wagiminator/CH32V003-GameConsole/README.md

# CH32V003 RISC-V Mini Game Console
Mini Game Console utilizing the CH32V003J4M6 ultra-cheap (10 cents by the time of writing) 32-bit RISC-V microcontroller, an SSD1306 128x64 pixels OLED display and CR/LIR2032 coin cell battery holder.

- Project Video (YouTube): https://youtu.be/1W7Z0BodhWk
- PCB Design Files (EasyEDA): https://oshwlab.com/wagiminator/ch32v003j4m6-game-console

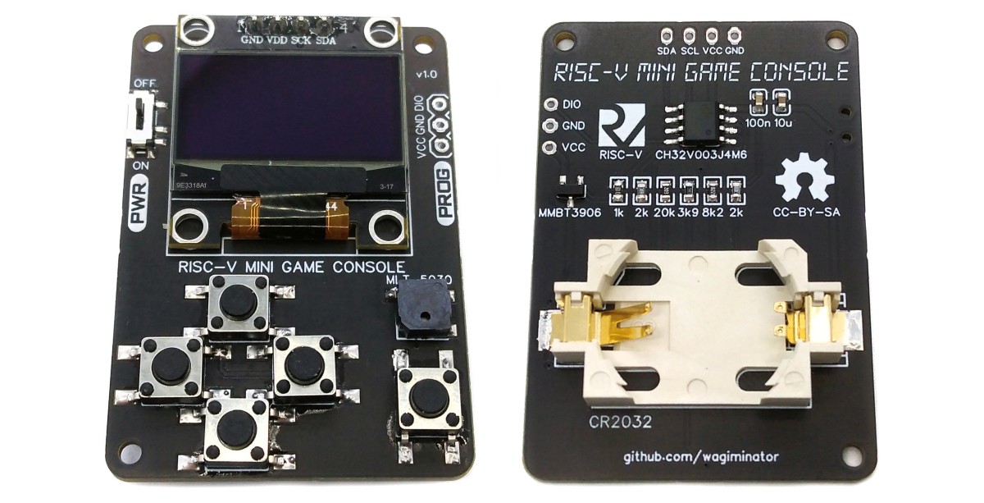
[picture p1: documentation/GameConsole_pic1.jpg]


# Hardware
## Schematic
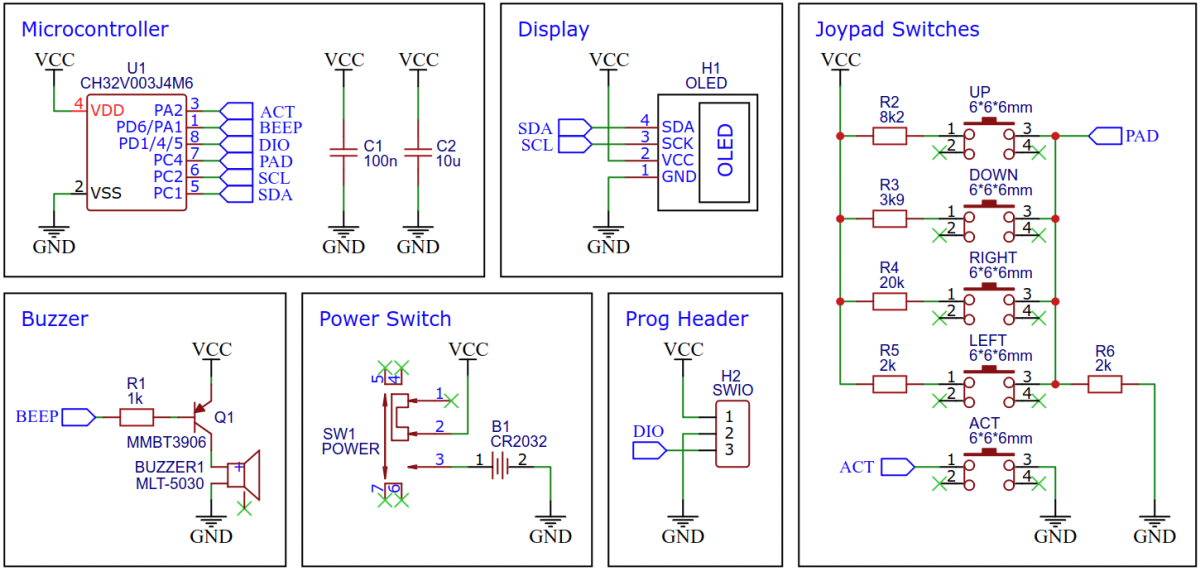
[picture p2: documentation/GameConsole_wiring.png]


## The CH32V003 Family of 32-bit RISC-V Microcontrollers
The CH32V003 series is a collection of industrial-grade general-purpose microcontrollers that utilize the QingKe RISC-V2A core design supporting the RV32EC instruction set. These microcontrollers are equipped with various features such as a 48MHz system main frequency, 16KB flash, 2KB SRAM, 2.7V - 5.5V supply voltage support, a single-wire serial debug interface, low power consumption, and an ultra-small package. Additionally, the CH32V003 series includes a built-in set of components including a DMA controller, a 10-bit ADC, op-amp comparators, multiple timers, and standard communication interfaces such as USART, I2C, and SPI.

## OLED Display
A low-cost SSD1306 4-pin I2C 128x64 pixels 0.96-inch OLED module is used as the display device. Make sure to acquire one with the correct pinout!

## Buzzer Circuit
Version 1.0 of the board controls the buzzer via a transistor. This increases the volume but can cause a voltage drop with weaker CR2032 3V batteries, potentially leading to a microcontroller brownout (this does not happen with the rechargeable LIR2032 3.6V batteries). Version 1.1 controls the buzzer directly through a low resistor, resulting in lower volume but preventing the brownout.

## Power Consumption
The average current consumption of the Mini Game Console is about 10mA at 3.6V, as measured with the [Power Profiler Kit II](https://www.nordicsemi.com/Products/Development-hardware/Power-Profiler-Kit-2).

## Building Instructions
1. Take the Gerber files (the *zip* file inside the *hardware* folder) and upload them to a PCB (printed circuit board) manufacturer of your choice (e.g., [JLCPCB](https://jlcpcb.com/)). They will use these files to create the circuit board for your device and send it to you.
2. Once you have the PCB, you can start soldering the components onto it. Use the BOM (bill of materials) and schematic as a guide to make sure everything is connected correctly. You can find the corresponding files in the *hardware* folder.
3. Upload the firmware by following the instructions in the section after next (see below).

## 3D Printable Case
1. Print the stl-files in the *3dprint* folder with your FDM Printer. Recommended settings: 0.2 mm layer height (0.1-0.15 mm for the buttons looks nicer), 3 perimeters, 20 % infill, PLA or PETG.
2. Put the D-pad and the fire button into their holes from the inside of the top part (front plate down on the table).
3. Put the PCB with the OLED facing down into the top part. The three corner pillars of the top part rest on the PCB around the mounting holes.
4. Put the bottom part on. Its inner rim fits into the step of the top part's wall.
5. Fasten everything with three **M2 x 12 countersunk screws** from the back. The screws cut their own thread into the 1.6 mm holes of the top part's pillars. Don't over-tighten them.

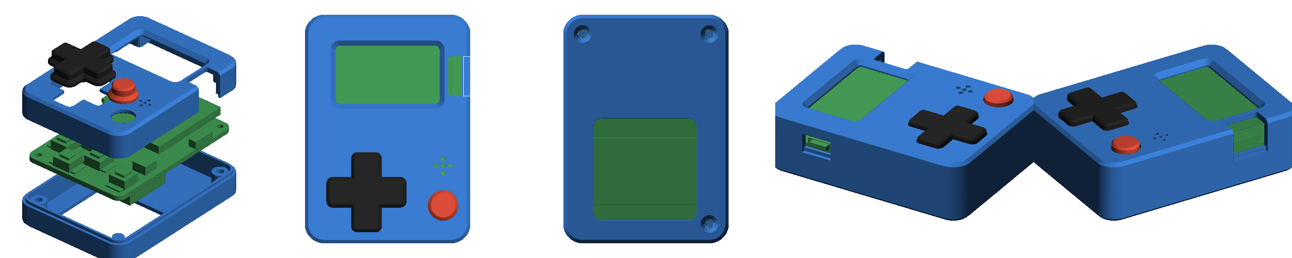
[picture p3: 3dprint/case_preview.png]


# Games
## Tiny Invaders
Tiny Invaders was originally developed by [Daniel Champagne](https://www.tinyjoypad.com/) for the ATtiny85. It is an adaptation of the classic game Space Invaders. The player controls a laser cannon that moves horizontally along the bottom of the screen. The objective is to defend the Earth from waves of descending alien invaders. The aliens move side to side, gradually descending towards the player, and the player's goal is to destroy them before they reach the bottom of the screen.

The player can shoot projectiles at the aliens and must strategically time their shots to hit the moving targets. As the game progresses, the aliens' movement becomes faster, making it more challenging to eliminate them. Additionally, the aliens periodically fire back at the player, creating a sense of urgency and adding to the gameplay difficulty.

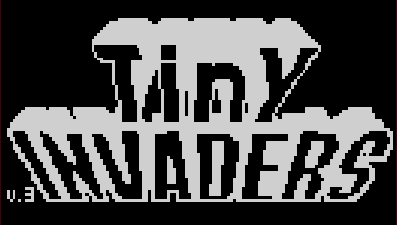
[picture p4: documentation/GameConsole_invaders_1.png]

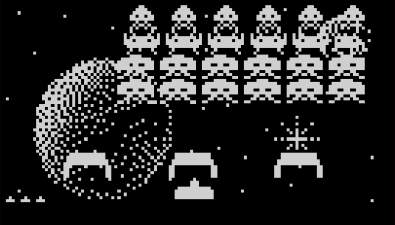
[picture p5: documentation/GameConsole_invaders_2.png]


## Tiny Lander
Tiny Lander was originally developed by [tscha70](https://github.com/tscha70/TinyLanderV1.0) for the ATtiny85. It is an adaptation of the classic game Lunar Lander that simulates the experience of piloting a spacecraft and landing it safely on the moon's surface. The objective of the game is to control the descent of the lunar lander module, adjusting the thrust and direction to ensure a smooth landing without crashing or running out of fuel. It requires careful maneuvering and precision to navigate the gravitational forces and terrain obstacles present on the moon.

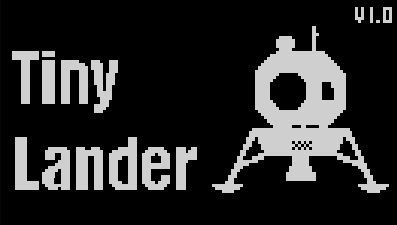
[picture p6: documentation/GameConsole_lander_1.png]

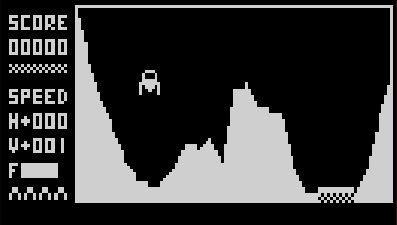
[picture p7: documentation/GameConsole_lander_2.png]


If you hold down the UP button on the start screen while pressing the fire button, the game will automatically start in a later level. On the other hand, if you hold down the DOWN button, you get 255 lives.

## Tiny Tris
Tiny Tris was originally developed by [Daniel Champagne](https://www.tinyjoypad.com/) for the ATtiny85. It is an adaptation of the well-known game Tetris. The objective of Tetris is to manipulate and arrange the falling Tetriminos to create complete horizontal lines without any gaps. When a line is completed, it clears from the playfield, and the player earns points. As the game progresses, the Tetriminos fall faster, increasing the challenge. If the Tetriminos stack up and reach the top of the playfield, the game ends.

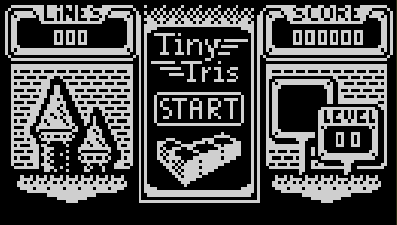
[picture p8: documentation/GameConsole_tris_1.png]

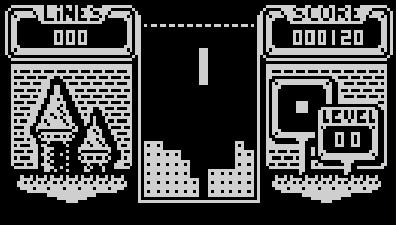
[picture p9: documentation/GameConsole_tris_2.png]


## Tiny Arkanoid
Tiny Arkanoid was originally developed by [Daniel Champagne](https://www.tinyjoypad.com/) for the ATtiny85. It is an adaptation of the classic game Arkanoid. The player controls a paddle at the bottom of the screen and uses it to bounce a ball against a wall of bricks at the top.

The objective of the game is to destroy all the bricks by hitting them with the ball. Each brick that is hit will disappear, and the player earns points for each brick destroyed. The ball bounces off the walls and the paddle, and the player must maneuver the paddle to keep the ball in play and prevent it from falling off the bottom of the screen.

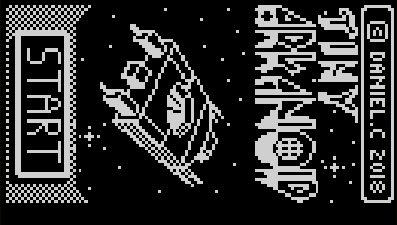
[picture p10: documentation/GameConsole_arkanoid_1.png]

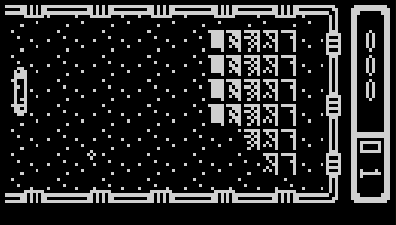
[picture p11: documentation/GameConsole_arkanoid_2.png]


## Tiny Pacman
Tiny Pacman was originally developed by [Daniel Champagne](https://www.tinyjoypad.com/) for the ATtiny85. The player controls a round character called Pacman, who must navigate through a maze filled with pellets and various types of enemies, known as ghosts. The objective of the game is for Pacman to eat all the pellets in the maze while avoiding the ghosts.

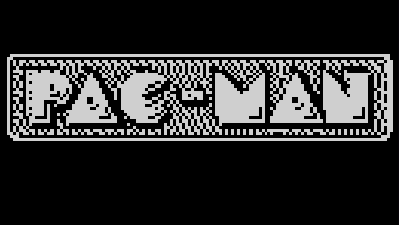
[picture p12: documentation/GameConsole_pacman_1.png]

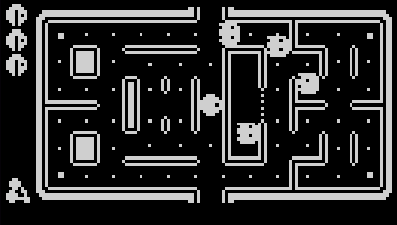
[picture p13: documentation/GameConsole_pacman_3.png]


## Tiny Doom
Can it play Doom? Oh yes, it can! Tiny Doom is a small Doom-like first person shooter. Fight your way through three levels full of zombies, demons and a cacodemon, open the doors, pick up medkits and ammo, and find the blinking exit switch of each level.

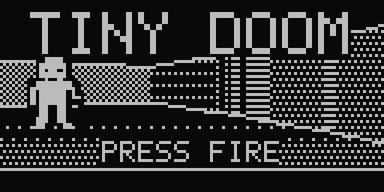
[picture p14: documentation/GameConsole_doom_1.png]

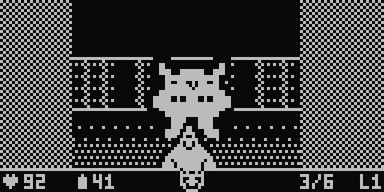
[picture p15: documentation/GameConsole_doom_3.png]


## Tiny Boulder
Tiny Boulder is a small Boulder Dash-like digging game. Dig your way through six scrolling caves, collect the required number of diamonds before the time runs out and escape through the exit. Watch out for falling boulders, fireflies and butterflies.

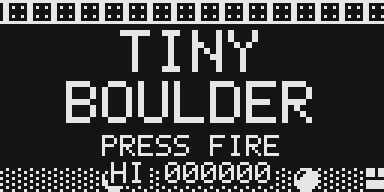
[picture p16: documentation/GameConsole_boulder_1.png]

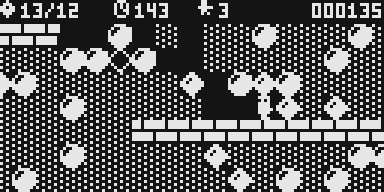
[picture p17: documentation/GameConsole_boulder_2.png]


## Tiny Bubble
Tiny Bubble is a small Bubble Bobble-like platform game. You are a little dragon who blows bubbles. Catch the monsters in bubbles, then burst the bubbles to defeat them and collect the fruit they leave behind. Clear all monsters to reach the next round, but hurry: after a while the monsters get angry, and then the invincible skull comes for you.

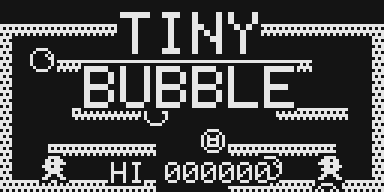
[picture p18: documentation/GameConsole_bubble_1.png]

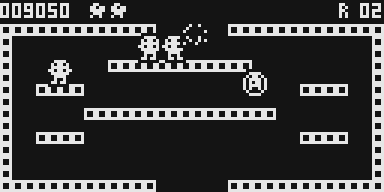
[picture p19: documentation/GameConsole_bubble_2.png]


## Tiny Karate
Tiny Karate is a small International Karate-like fighting game. You (white) fight against the computer (black) in front of a mountain and a pagoda. Score points with punches and kicks, block or dodge the attacks of your opponent and earn a new belt with every won bout.

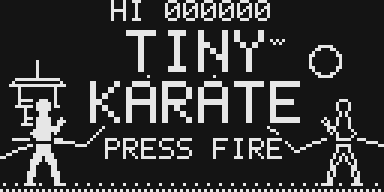
[picture p20: documentation/GameConsole_karate_1.png]

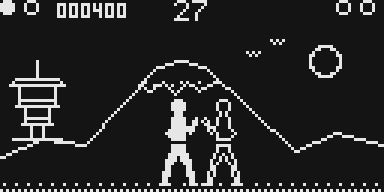
[picture p21: documentation/GameConsole_karate_2.png]


## Tiny Run
Tiny Run is a small Out Run-like racing game. Race your convertible along the coast, through the desert, the mountains and the city. Reach the checkpoint at the end of each stage before the time runs out. At each checkpoint the road forks, and the road you take decides the next stage. Five stages in a row bring you to the goal.

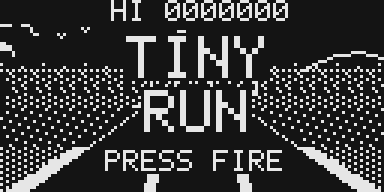
[picture p22: documentation/GameConsole_run_1.png]

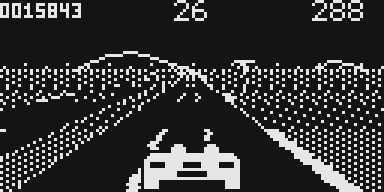
[picture p23: documentation/GameConsole_run_3.png]


## Tiny Shooter
Tiny Shooter is a small horizontally scrolling shoot'em up game. Fly through open space, over hills and through narrow caves, shoot down waves of enemies, collect power capsules for a stronger gun and defeat the guardian at the end of each stage. Every stage is faster and more crowded than the one before.

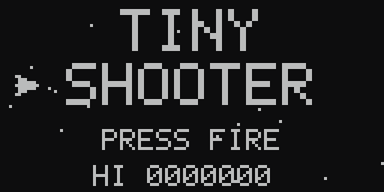
[picture p24: documentation/GameConsole_shooter_1.png]

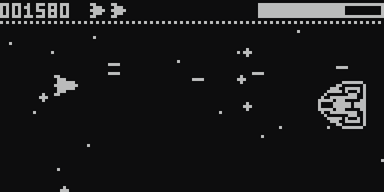
[picture p25: documentation/GameConsole_shooter_3.png]


## Tiny Sisters
Tiny Sisters is a small Giana Sisters/Super Mario Bros-like jump'n'run game. Run and jump through sixteen scrolling levels: meadows, hills, caves, lakes, forests, the sky and castles. Jump on owls, beetles, frogs, bees and fish, but beware of the spiky hedgehogs. Bump your head against the bonus blocks to get diamonds. The magic wheel turns the sister into a punk who can smash bricks, the dream orb lets her throw bouncing dream bubbles. Reach the exit gate of each level before the time runs out, and defeat the owl king at the end of each castle.

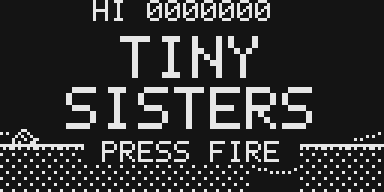
[picture p26: documentation/GameConsole_sisters_1.png]

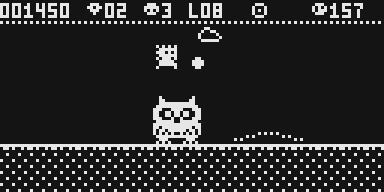
[picture p27: documentation/GameConsole_sisters_3.png]


## Tiny Blaster
Tiny Blaster is a small vertically scrolling shoot'em up in the style of Xenon II: Megablast. Fly through five stages with canyons and rock walls and fight drones, weavers, divers, chasers, wall turrets, spinners, asteroids and capsule pods, and finally the big guardian at the end of each stage. Collect the credit bubbles of destroyed enemies and spend them in the weapon shop before each stage: gun power-ups, side shots, rear shots, homing missiles, laser, cannon, wing drones, the orbiting electro ball, speed-ups, autofire, energy refill, extra lives and the mighty Nashwan power, which gives you all weapons for a short time. Capsules dropped by pods contain weapons, energy or Nashwan power as well. After the fifth stage, the game starts over with tougher enemies.

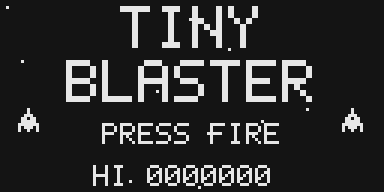
[picture p28: documentation/GameConsole_blaster_1.png]

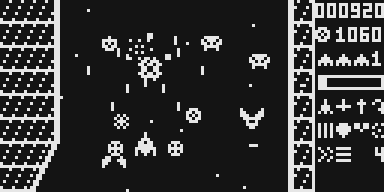
[picture p29: documentation/GameConsole_blaster_2.png]


## Tiny Hurrican
Tiny Hurrican is a small run'n'gun game in the style of Turrican. Explore six large levels in three worlds - caves, a technical base and an alien hive - that scroll in all directions. Fight walkers, hoppers, soldiers, flyers, droppers, homing eyes, wall turrets, generators and giant walkers, and defeat the guardian at the end of each world. Shoot the power blocks to get the multiple shot, the laser or the rebound shot (each with three power levels), energy, a shield, extra lives, power lines and gyroscope wheels. Hold the fire button to use the rotatable lightning beam, roll through narrow tunnels as a gyroscope wheel and release the power lines to clear the screen. Invisible blocks, breakable walls and hidden tunnels lead to secret rooms full of diamonds. Reach the exit before the time runs out.

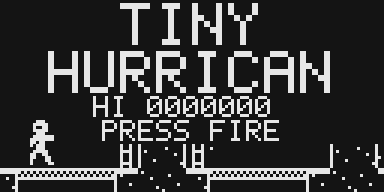
[picture p30: documentation/GameConsole_hurrican_1.png]

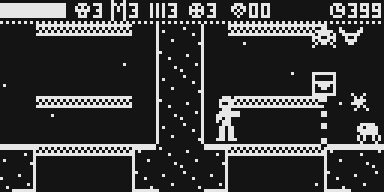
[picture p31: documentation/GameConsole_hurrican_2.png]


## Tiny RPG
A small open-world action RPG developed by [Sergey Smirnov](https://github.com/fatalists/CH32V003-TinyRPG). The game is inspired by the Dark Souls series, Elden Ring, Ragnarok Online and Dota 2. Defeat Malenia, who waits at the far end of Valhalla, north of the snowfield. She is by far the strongest creature in the world. Two other bosses guard caves in the desert and the snowfield. They are optional, but the gear they drop makes the road to Malenia a lot shorter.

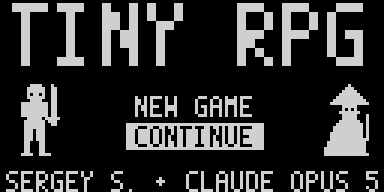
[picture p32: documentation/GameConsole_rpg_1.png]

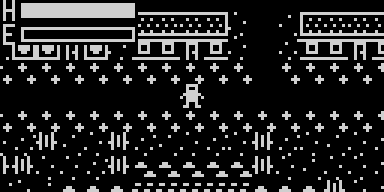
[picture p33: documentation/GameConsole_rpg_2.png]


# Compiling and Uploading Firmware
## Programming and Debugging Device
To program the CH32V003 microcontroller, you will need a special programming device which utilizes the proprietary single-wire serial debug interface (SDI). The [WCH-LinkE](http://www.wch-ic.com/products/WCH-Link.html) (pay attention to the "E" in the name) is a suitable device for this purpose and can be purchased commercially for around $4. This debugging tool is not only compatible with the CH32V003 but also with other WCH RISC-V and ARM-based microcontrollers.



To use the WCH-LinkE on Linux, you need to grant access permissions beforehand by executing the following commands:
```
echo 'SUBSYSTEM=="usb", ATTR{idVendor}=="1a86", ATTR{idProduct}=="8010", MODE="666"' | sudo tee /etc/udev/rules.d/99-WCH-LinkE.rules
echo 'SUBSYSTEM=="usb", ATTR{idVendor}=="1a86", ATTR{idProduct}=="8012", MODE="666"' | sudo tee -a /etc/udev/rules.d/99-WCH-LinkE.rules
sudo udevadm control --reload-rules
```

On Windows, if you need to you can install the WinUSB driver over the WCH interface 1 using the [Zadig](https://zadig.akeo.ie/) tool.

To upload the firmware, you need to ensure that the Game Console is switched off or the battery is removed. Then, you should make the following connections to the WCH-LinkE:

```
WCH-LinkE     GameConsole
+-------+      +-------+
|  SWDIO| <--> |DIO    |
|    GND| ---> |GND    |
|    3V3| ---> |VCC    |
+-------+      +-------+
```

If the blue LED on the WCH-LinkE remains illuminated once it is connected to the USB port, it means that the device is currently in ARM mode and must be switched to RISC-V mode initially. There are a few ways to accomplish this:
- You can utilize the Python command-line tool [rvprog](https://pypi.org/project/rvprog/) (with *-v* option).
- Alternatively, you can select "WCH-LinkRV" in the software provided by WCH, such as MounRiver Studio or WCH-LinkUtility.
- Another option is to hold down the ModeS button on the device while plugging it into the USB port.

More information can be found in the [WCH-Link User Manual](http://www.wch-ic.com/downloads/WCH-LinkUserManual_PDF.html).

## Uploading a Game using the Web App
The easiest way to upload a game to the GameConsole is by using the [Web App](https://wagiminator.github.io/apps/gameconsole/). This only works in Chrome, Edge, or Opera browsers on a desktop PC. The prerequisites mentioned above regarding drivers or udev rules must be met.

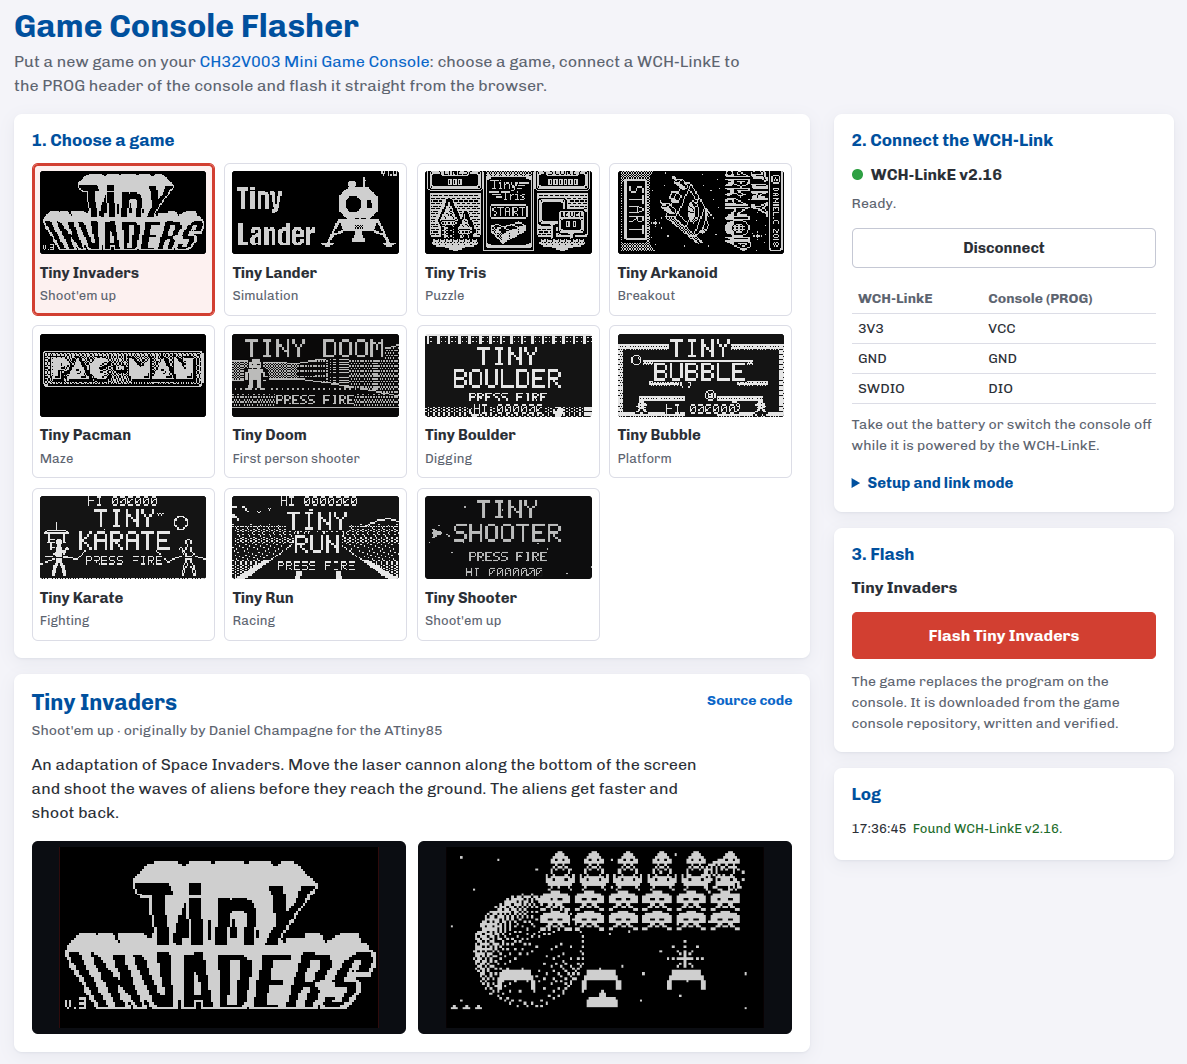
[picture p34: documentation/GameConsole_webapp.png]


## Compiling and Uploading Firmware using the Makefile
### Linux
Install the toolchain (GCC compiler, Python3, and rvprog):
```
sudo apt install build-essential libnewlib-dev gcc-riscv64-unknown-elf
sudo apt install python3 python3-pip
pip install rvprog
```

Switch off the Game Console or remove the battery. Connect the Console via the 3-pin PROG header to the programming device. Open a terminal and navigate to the folder with the *makefile*. Run the following command to compile and upload:
```
make flash
```

### Other Operating Systems
Follow the instructions on [CNLohr's ch32v003fun page](https://github.com/cnlohr/ch32v003fun/wiki/Installation) to set up the toolchain on your respective operating system (for Windows, use WSL). Also, install [Python3](https://www.pythontutorial.net/getting-started/install-python/) and [rvprog](https://pypi.org/project/rvprog/). Compile and upload with "make flash". Note that I only have Debian-based Linux and have not tested it on other operating systems.

## Compiling and Uploading Firmware using PlatformIO
- Install [PlatformIO](https://platformio.org) and [platform-ch32v](https://github.com/Community-PIO-CH32V/platform-ch32v). Follow [these instructions](https://pio-ch32v.readthedocs.io/en/latest/installation.html) to do so. Linux/Mac users may also need to install [pyenv](https://realpython.com/intro-to-pyenv).
- Click on "Open Project" and select the firmware folder with the *platformio.ini* file.
- Switch off the Game Console or remove the battery. Connect the WCH-LinkE to the board. Then click "Upload".

## Uploading pre-compiled Firmware Binary
WCH offers the free but closed-source software [WCH-LinkUtility](https://www.wch.cn/downloads/WCH-LinkUtility_ZIP.html) to upload the precompiled hex-file with Windows. Select the "WCH-LinkRV" mode in the software, open the *<firmware>.hex* file in the *bin* folder and upload it to the microcontroller.

Alternatively, there is an open-source tool called [minichlink](https://github.com/cnlohr/ch32v003fun/tree/master/minichlink) developed by Charles Lohr (CNLohr). It can be used with Windows, Linux and Mac.

If you have installed [Python3](https://www.pythontutorial.net/getting-started/install-python/) on your system, you can also use the platform-independent open-source command-line tool [rvprog](https://pypi.org/project/rvprog/) for uploading:
```
rvprog -f bin/<firmware>.bin
```

# Browser-based Simulation
If you want to play the games in your web-browser, then take a look [here](https://v86-riscv.turret13.workers.dev/?build=gameconsole-tris).

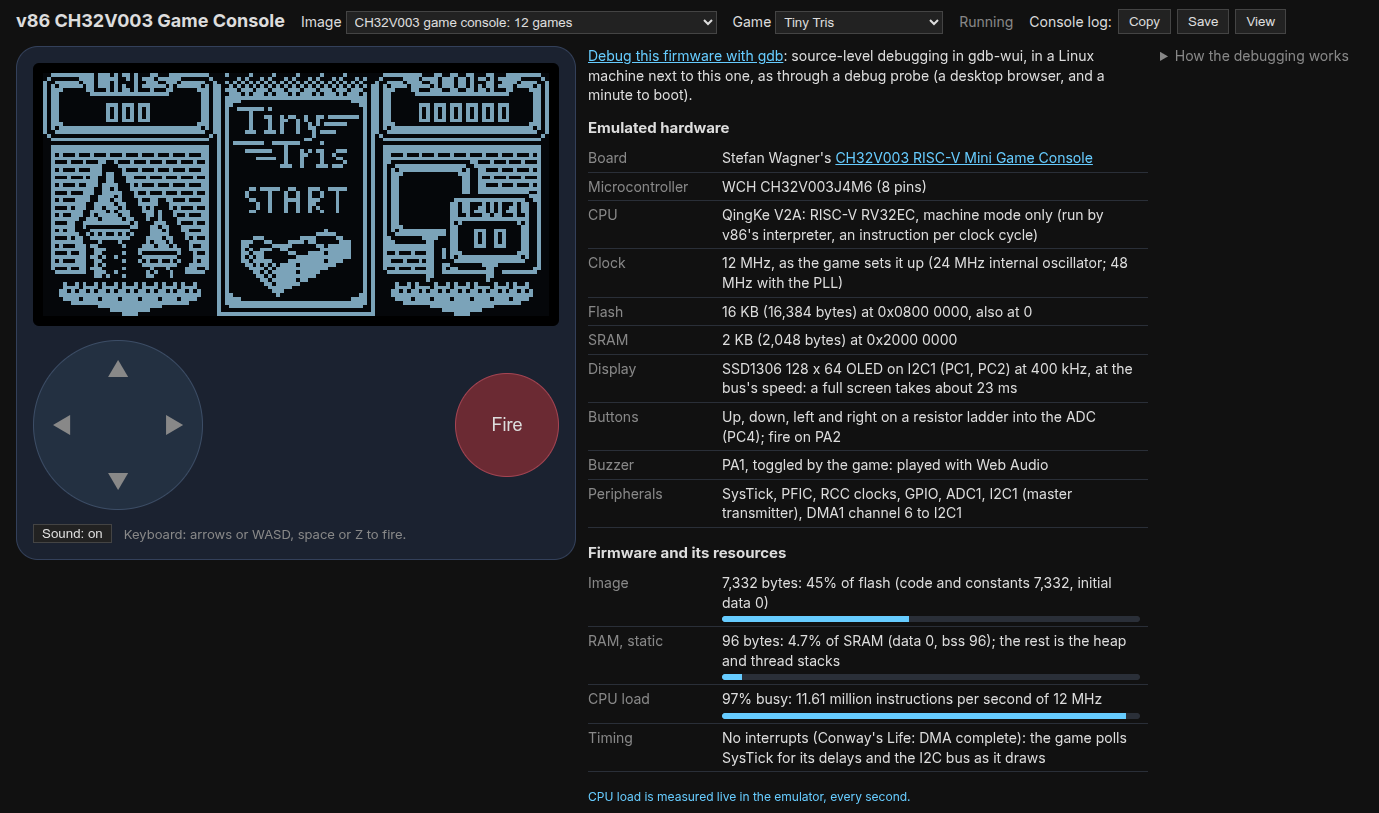
[picture p35: documentation/GameConsole_emulation.png]


# References, Links and Notes
- [Game Console Flasher Web App](https://wagiminator.github.io/apps/gameconsole/)
- [EasyEDA Design Files](https://oshwlab.com/wagiminator)
- [MCU Templates](https://github.com/wagiminator/MCU-Templates)
- [MCU Flash Tools](https://github.com/wagiminator/MCU-Flash-Tools)
- [DanielC: Tinyjoypad](https://www.tinyjoypad.com/)
- [CNLohr: ch32003fun](https://github.com/cnlohr/ch32v003fun)
- [WCH: CH32V003 datasheets](http://www.wch-ic.com/products/CH32V003.html)
- [WCH: WCH-Link user manual](http://www.wch-ic.com/downloads/WCH-LinkUserManual_PDF.html)
- [WCH: Official Store on AliExpress](https://wchofficialstore.aliexpress.com)
- [Browser Emulation](https://v86-riscv.turret13.workers.dev/?build=gameconsole-tris)

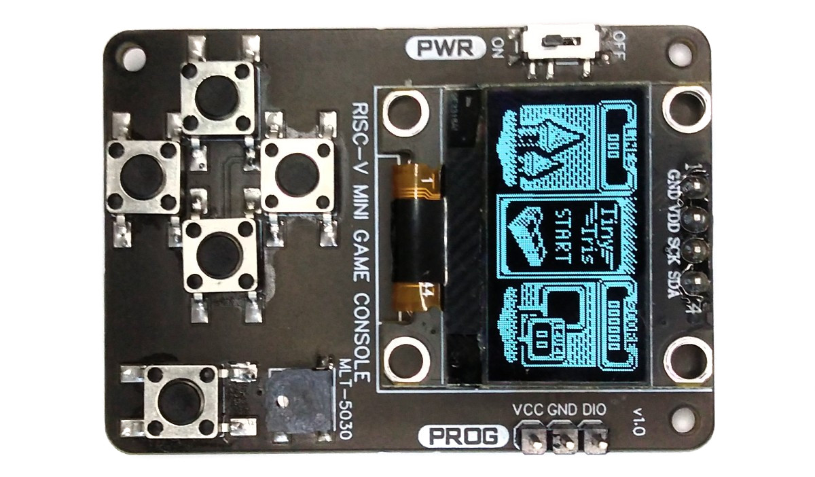
[picture p36: documentation/GameConsole_pic2.jpg]


# License



This work is licensed under Creative Commons Attribution-ShareAlike 3.0 Unported License. 
(http://creativecommons.org/licenses/by-sa/3.0/)
