wagiminator/CH32V003-GameConsole/documentation/GameConsole_blaster_3.png

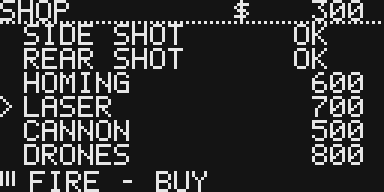
documentation/GameConsole_blaster_3.png
