wagiminator/CH32V003-GameConsole/documentation/GameConsole_blaster_4.png

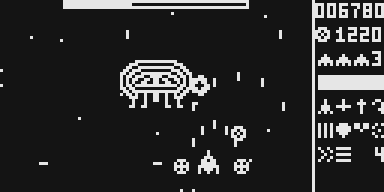
documentation/GameConsole_blaster_4.png
