wagiminator/CH32V003-GameConsole/documentation/GameConsole_boulder.gif

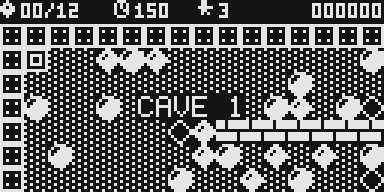
documentation/GameConsole_boulder.gif
