wagiminator/CH32V003-GameConsole/documentation/GameConsole_boulder_3.png

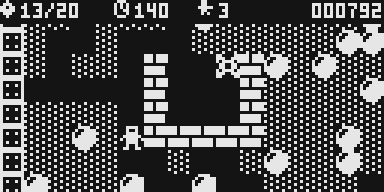
documentation/GameConsole_boulder_3.png
