wagiminator/CH32V003-GameConsole/documentation/GameConsole_bubble.gif

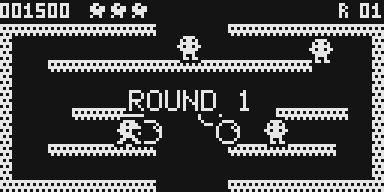
documentation/GameConsole_bubble.gif
