wagiminator/CH32V003-GameConsole/documentation/GameConsole_bubble_3.png

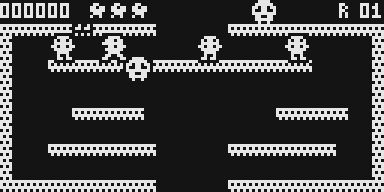
documentation/GameConsole_bubble_3.png
