wagiminator/CH32V003-GameConsole/documentation/GameConsole_doom.gif

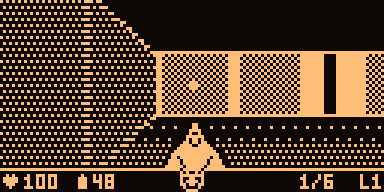
documentation/GameConsole_doom.gif
