wagiminator/CH32V003-GameConsole/documentation/GameConsole_doom_2.png

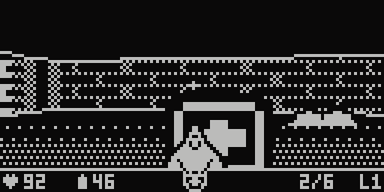
documentation/GameConsole_doom_2.png
