wagiminator/CH32V003-GameConsole/documentation/GameConsole_hurrican_3.png

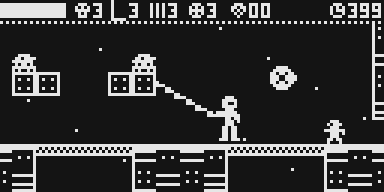
documentation/GameConsole_hurrican_3.png
