wagiminator/CH32V003-GameConsole/documentation/GameConsole_hurrican_4.png

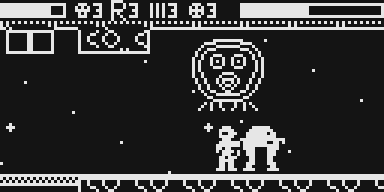
documentation/GameConsole_hurrican_4.png
