wagiminator/CH32V003-GameConsole/documentation/GameConsole_karate.gif

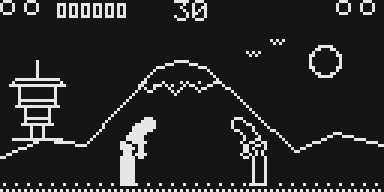
documentation/GameConsole_karate.gif
