wagiminator/CH32V003-GameConsole/documentation/GameConsole_run.gif

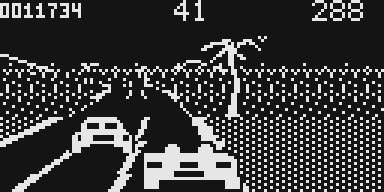
documentation/GameConsole_run.gif
