wagiminator/CH32V003-GameConsole/documentation/GameConsole_run_2.png

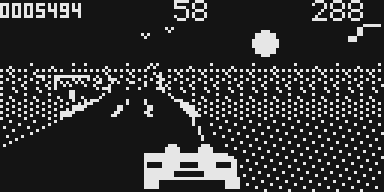
documentation/GameConsole_run_2.png
