wagiminator/CH32V003-GameConsole/documentation/GameConsole_shooter.gif

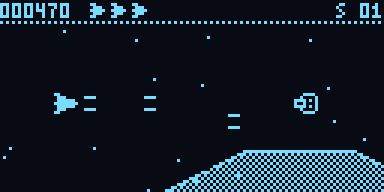
documentation/GameConsole_shooter.gif
