wagiminator/CH32V003-GameConsole/documentation/GameConsole_shooter_2.png

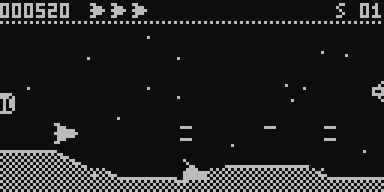
documentation/GameConsole_shooter_2.png
