wagiminator/CH32V003-GameConsole/documentation/GameConsole_sisters_2.png

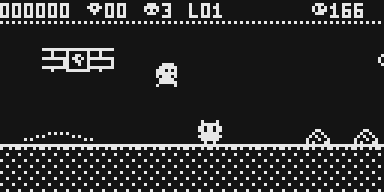
documentation/GameConsole_sisters_2.png
