wagiminator/CH32V003-GameConsole/hardware/GameConsole_v1.1_BOM.tsv

ID | Name | Designator | Footprint | Quantity | Manufacturer Part | Manufacturer | Supplier | Supplier Part
1 | 6*6*6mm | ACT,DOWN,LEFT,RIGHT,UP | KEY-6.0*6.0 | 5 | SMD Tactile Switch6*6*6mm | ReliaPro | LCSC | C23873
2 | CR2032 | B1 | BATTERY-3 | 1 | CR2032-BS-6-1 | Q&J | LCSC | C70377
3 | MLT-5030 | BUZZER1 | MLT-5030 | 1 | MLT-5030 | HNDZ | LCSC | C95297
4 | 100n | C1 | C_0603 | 1 | CC0603KRX7R9BB104 | YAGEO | LCSC | C14663
5 | 10u | C2 | C_0603 | 1 | CL10A106KP8NNNC | SAMSUNG | LCSC | C19702
6 | OLED | H1 | I2C OLED 0.96 NEW | 1 | SSD1306 I2C OLED
7 | SWIO | H2 | 210S-3X1/2.54 | 1 | Header2.54mm 1*3P | BOOMELE | LCSC | C49257
8 | 22R | R1 | 0603 | 1 | 0603WAF220JT5E | UNI-ROYAL(厚声) | LCSC | C23345
9 | 8k2 | R2 | 0603 | 1 | 0603WAF8201T5E | UniOhm | LCSC | C25981
10 | 3k9 | R3 | 0603 | 1 | 0603WAF3901T5E | UniOhm | LCSC | C23018
11 | 20k | R4 | 0603 | 1 | 0603WAF2002T5E | UniOhm | LCSC | C4184
12 | 2k | R5,R6 | 0603 | 2 | 0603WAF2001T5E | UniOhm | LCSC | C22975
13 | POWER | SW1 | SW-SMD_SS-1290L-GLL-1.5MM | 1 | SS-1290L-GL L=1.5mm | RI SHENG | LCSC | C695418
14 | CH32V003J4M6 | U1 | SOP-8_150MIL | 1 | CH32V003J4M6 | WCH(Jiangsu Qin Heng) | LCSC | C5346354
