wagiminator/CH32V003-GameConsole/3dprint/GameConsole_button_dpad.stl

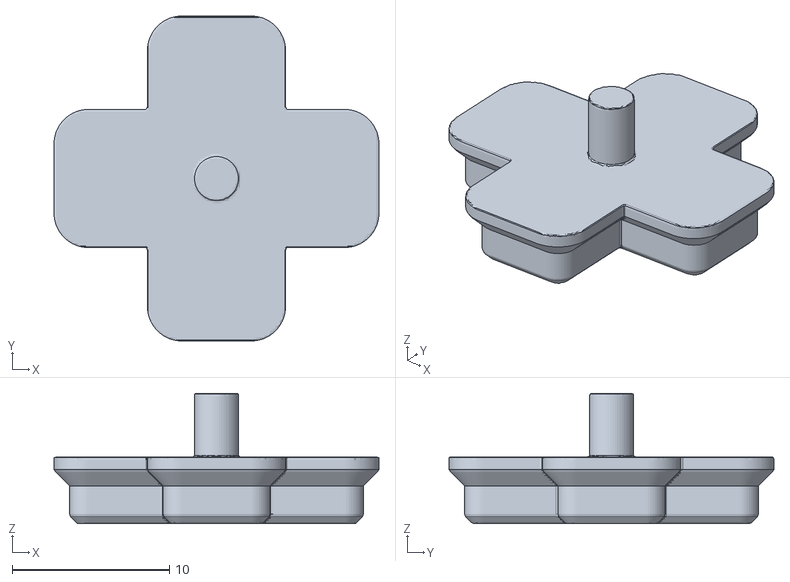
[picture p53: CAD file, 2026-10-31]
3dprint/GameConsole_button_dpad.stl
20.7 x 20.7 x 8.30
