wagiminator/CH32V003-GameConsole/3dprint/GameConsole_button_fire.stl

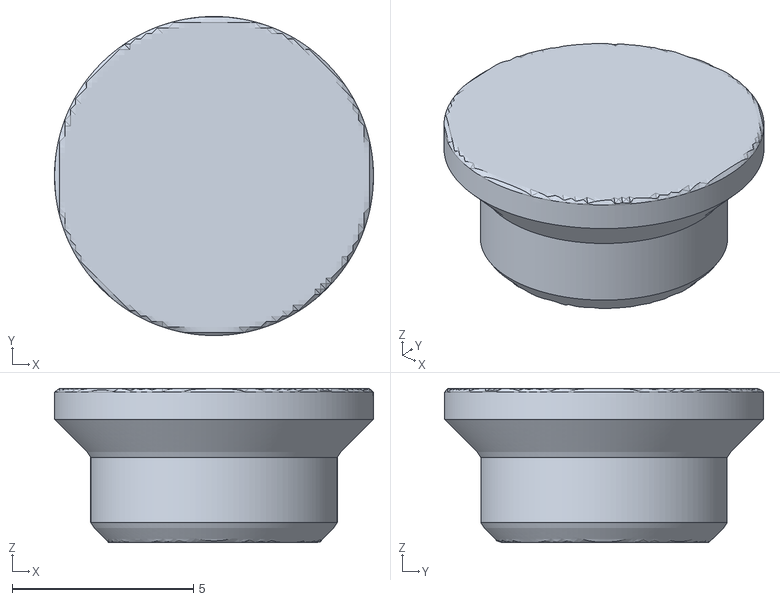
[picture p54: CAD file, 2026-10-31]
3dprint/GameConsole_button_fire.stl
8.80 x 8.80 x 4.25
