wagiminator/CH32V003-GameConsole/3dprint/GameConsole_case_top.stl

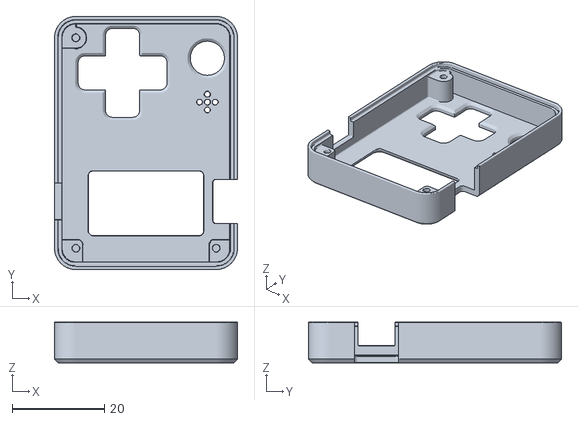
[picture p55: CAD file, 2026-10-31]
3dprint/GameConsole_case_top.stl
39.8 x 55.0 x 8.90
