wagiminator/CH32V003-GameConsole/3dprint/GameConsole_case_bottom.stl

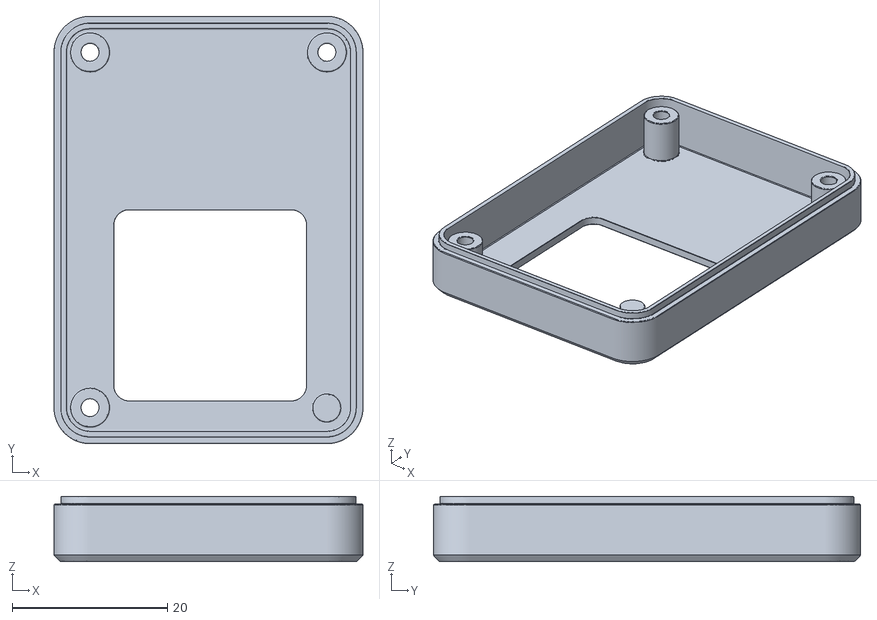
[picture p56: CAD file, 2026-10-31]
3dprint/GameConsole_case_bottom.stl
39.8 x 55.0 x 8.40
