wagiminator/CH32V003-GameConsole/(threads)

Thread 5 (2024-08-21):

Charger circuit?

mahagr, 2024-08-21:
As the microcontroller kinda requires 2.7V and the low audio volume in V1.1, why not make a version with a cheap lipo charger circuit with USB input?

wagiminator, 2024-08-24:
I had considered this option too, but in the end, I wanted to use as few/as cheap components as possible and also use up all the CR2032 batteries I still have lying around.

mahagr, 2024-08-25:
I want to build a few of these with my son with rechargeable batteries, but my skills in electronics are still pretty bad. I already ordered the parts, including DW01+F5805A, MCPT73831T and USB-C connector. The extra components add less than 0.30€ to the price.

Can I just add the needed circuits to the board or is there anything else I need to consider first?

wagiminator, 2024-08-25:
I think that should work without any problems. When selecting the charging IC, make sure to choose the version with a 4.2V charging voltage (MCP73831T-2) if possible, as LIR2032 batteries don't handle high charging voltages very well.

mahagr, 2024-08-25:
Yup, it's the -2 variant, just like in your LIR charger chip.

mahagr, 2024-09-10:
I created a private version of the modified circuit and added you into the project. Can you please check it out as I have no experience of creating circuits. Thank you.

wagiminator, 2024-09-15:
That looks good, I’m excited to see if it works!

mahagr, 2024-09-16:
I will update you. I also made some minor changes to your PD tester hw to hopefully support up to 140W.

I will likely make the order this week, so we'll see if it works in a few weeks. After that we will try to port a few extra games to this. :)

Thank you for responding.

Thread 6 (2025-01-30):

LCSC Part Number can't be matched

MayNiklas, 2025-01-30:
Hey!
First of all: thank you for your amazing projects!

I have a lot of fun, building a few of them!
I'm currently trying to source this project.

LCSC isn't able to match the part number `C23873`(tactile switches) to anything.
See: https://www.lcsc.com/search?q=C23873

Do you have any other information, that might help me source similar switches?

Thank you!!

PS: your PD tester is amazing - super helpful!

Kind regards,
MayNiklas

MayNiklas, 2025-01-31:
Just in case others might be asking the same question:
I noticed, that the switches used have a super common form factor.
A lot of switches such as # C255812 should work.

Closed 2025-03-22.

Thread 7 (2025-08-06):

Issues on battery power

wiebel, 2025-08-06:
Everything works fine when powered via the wchlink. But as soon as I use the battery, first I need to toggle the switch at twice to get it to boot correctly and then the ACT button does act weirdly so I cant start a game.  The game of life shows no such problems so I suspect it to be a debouncing issue connected with a lower voltage.

wiebel, 2025-08-06:
Turned out to be a bad battery.
