wagiminator/CH32V003-GameConsole/hardware/GameConsole_v1.1_schematic.pdf

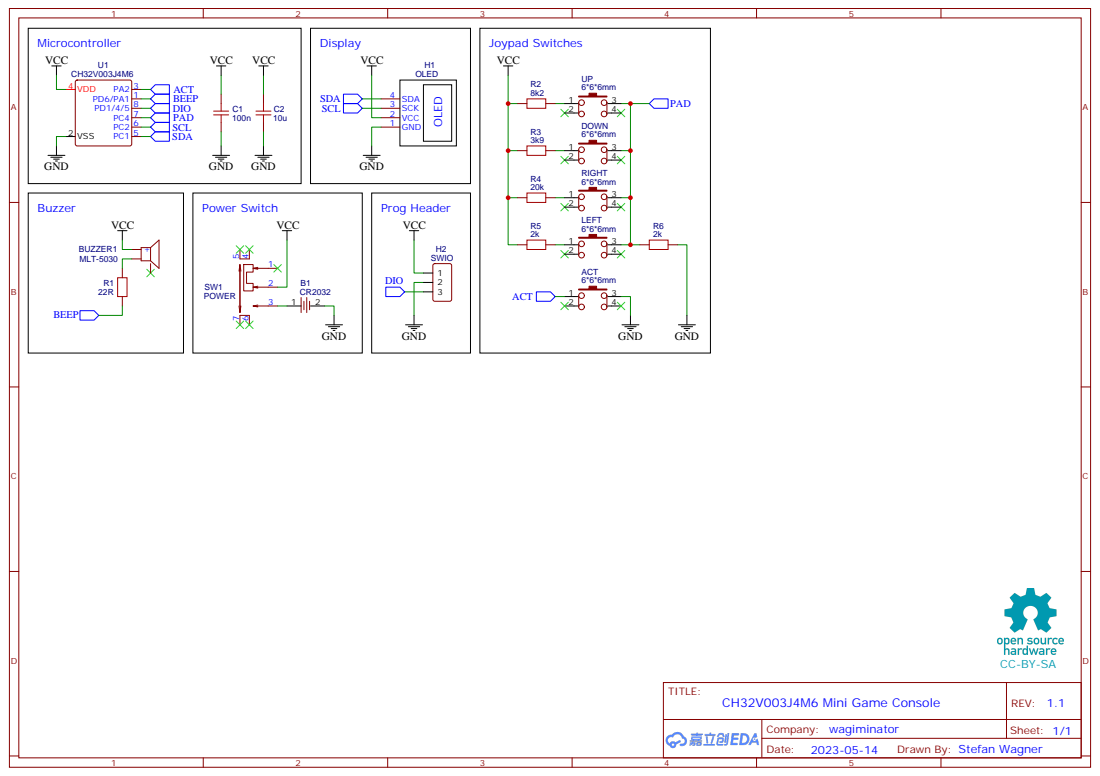
[picture p57: page 1]

Drawn By: Stefan Wagner
