wagiminator/CH32V003-GameConsole/hardware/GameConsole_v1.0_schematic.pdf

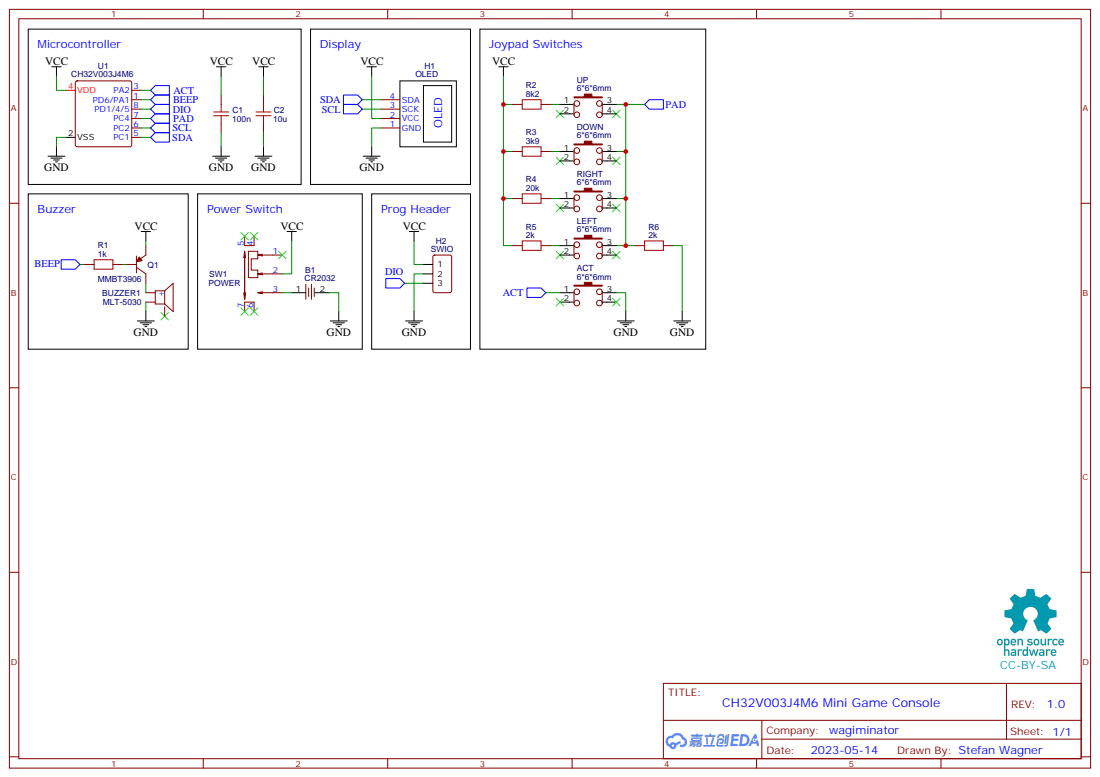
[picture p58: page 1]

Drawn By: Stefan Wagner
