wagiminator/CH32V003-GameConsole/software/tiny_blaster/src/ch32v003.h

// ===================================================================================
// Header File for CH32V003                                                   * v1.6 *
// ===================================================================================
// This contains a copy of ch32v00x.h and core_riscv.h and other misc functions.
// NOTE: This file includes modifications by CNLohr.
// NOTE: This file includes modifications by Stefan Wagner.
/********************************** (C) COPYRIGHT  *******************************
 * File Name          : ch32v00x.h
 * Author             : WCH
 * Version            : V1.0.0
 * Date               : 2022/08/08
 * Description        : CH32V00x Device Peripheral Access Layer Header File.
 *********************************************************************************
 * Copyright (c) 2021 Nanjing Qinheng Microelectronics Co., Ltd.
 * Attention: This software (modified or not) and binary are used for 
 * microcontroller manufactured by Nanjing Qinheng Microelectronics.
 *******************************************************************************/
 
#pragma once

/* MCU definitions */
#define __MPU_PRESENT             0  /* Other CH32 devices does not provide an MPU */
#define __Vendor_SysTickConfig    0  /* Set to 1 if different SysTick Config is used */

#ifdef __ASSEMBLER__
#define HSE_VALUE                 (24000000)  /* Value of the external oscillator in Hz */
#define HSI_VALUE                 (24000000)  /* Value of the internal oscillator in Hz */
#define LSI_VALUE                 (  128000)  /* Value of the internal low-speed oscillator in Hz */
#define HSE_STARTUP_TIMEOUT       (  0x2000)  /* Time out for HSE start up */
#define HSITRIM                   (    0x10)  /* HSI TRIM value */
#else
#define HSE_VALUE                 ((uint32_t)24000000)  /* Value of the external oscillator in Hz */
#define HSI_VALUE                 ((uint32_t)24000000)  /* Value of the internal oscillator in Hz */
#define LSI_VALUE                 ((uint32_t)  128000)  /* Value of the internal low-speed oscillator in Hz */
#define HSE_STARTUP_TIMEOUT       ((uint16_t)  0x2000)  /* Time out for HSE start up */
#define HSITRIM                   ((uint8_t)     0x10)  /* HSI TRIM value */
#endif

/* Standard Peripheral Library old definitions (maintained for legacy purpose) */
#define HSI_Value                 HSI_VALUE
#define HSE_Value                 HSE_VALUE
#define HSEStartUp_TimeOut        HSE_STARTUP_TIMEOUT

#ifndef __ASSEMBLER__             // Things before this can be used in assembly.

#ifdef __cplusplus
extern "C" {
#endif
#include <stdint.h>

/* Interrupt Number Definition, according to the selected device */
typedef enum IRQn
{
    /******  RISC-V Processor Exceptions Numbers *************************************/
    NonMaskableInt_IRQn = 2, /* 2 Non Maskable Interrupt                             */
    EXC_IRQn = 3,            /* 3 Exception Interrupt                                */
    SysTicK_IRQn = 12,       /* 12 System timer Interrupt                            */
    Software_IRQn = 14,      /* 14 software Interrupt                                */

    /******  RISC-V specific Interrupt Numbers ***************************************/
    WWDG_IRQn = 16,          /* Window WatchDog Interrupt                            */
    PVD_IRQn = 17,           /* PVD through EXTI Line detection Interrupt            */
    FLASH_IRQn = 18,         /* FLASH global Interrupt                               */
    RCC_IRQn = 19,           /* RCC global Interrupt                                 */
    EXTI7_0_IRQn = 20,       /* External Line[7:0] Interrupts                        */
    AWU_IRQn = 21,           /* AWU global Interrupt                                 */
    DMA1_Channel1_IRQn = 22, /* DMA1 Channel 1 global Interrupt                      */
    DMA1_Channel2_IRQn = 23, /* DMA1 Channel 2 global Interrupt                      */
    DMA1_Channel3_IRQn = 24, /* DMA1 Channel 3 global Interrupt                      */
    DMA1_Channel4_IRQn = 25, /* DMA1 Channel 4 global Interrupt                      */
    DMA1_Channel5_IRQn = 26, /* DMA1 Channel 5 global Interrupt                      */
    DMA1_Channel6_IRQn = 27, /* DMA1 Channel 6 global Interrupt                      */
    DMA1_Channel7_IRQn = 28, /* DMA1 Channel 7 global Interrupt                      */
    ADC_IRQn = 29,           /* ADC global Interrupt                                 */
    I2C1_EV_IRQn = 30,       /* I2C1 Event Interrupt                                 */
    I2C1_ER_IRQn = 31,       /* I2C1 Error Interrupt                                 */
    USART1_IRQn = 32,        /* USART1 global Interrupt                              */
    SPI1_IRQn = 33,          /* SPI1 global Interrupt                                */
    TIM1_BRK_IRQn = 34,      /* TIM1 Break Interrupt                                 */
    TIM1_UP_IRQn = 35,       /* TIM1 Update Interrupt                                */
    TIM1_TRG_COM_IRQn = 36,  /* TIM1 Trigger and Commutation Interrupt               */
    TIM1_CC_IRQn = 37,       /* TIM1 Capture Compare Interrupt                       */
    TIM2_IRQn = 38,          /* TIM2 global Interrupt                                */
} IRQn_Type;

#define HardFault_IRQn        EXC_IRQn

/* IO definitions */
#ifdef __cplusplus
  #define   __I     volatile            /*!< defines 'read only' permissions    */
#else
  #define   __I     volatile const      /*!< defines 'read only' permissions    */
#endif
#define     __O     volatile            /*!< defines 'write only' permissions   */
#define     __IO    volatile            /*!< defines 'read / write' permissions */

/* define compiler specific symbols */
#define __ASM       __asm               /*!< asm keyword for GNU Compiler       */
#define __INLINE    inline              /*!< inline keyword for GNU Compiler    */

typedef enum {NoREADY = 0, READY = !NoREADY} ErrorStatus;
typedef enum {DISABLE = 0, ENABLE = !DISABLE} FunctionalState;
typedef enum {RESET = 0, SET = !RESET} FlagStatus, ITStatus;

/* Analog to Digital Converter */
typedef struct
{
    __IO uint32_t STATR;
    __IO uint32_t CTLR1;
    __IO uint32_t CTLR2;
    __IO uint32_t SAMPTR1;
    __IO uint32_t SAMPTR2;
    __IO uint32_t IOFR1;
    __IO uint32_t IOFR2;
    __IO uint32_t IOFR3;
    __IO uint32_t IOFR4;
    __IO uint32_t WDHTR;
    __IO uint32_t WDLTR;
    __IO uint32_t RSQR1;
    __IO uint32_t RSQR2;
    __IO uint32_t RSQR3;
    __IO uint32_t ISQR;
    __IO uint32_t IDATAR1;
    __IO uint32_t IDATAR2;
    __IO uint32_t IDATAR3;
    __IO uint32_t IDATAR4;
    __IO uint32_t RDATAR;
    __IO uint32_t DLYR;
} ADC_TypeDef;

/* Debug MCU */
typedef struct
{
    __IO uint32_t CFGR0;
    __IO uint32_t CFGR1;
} DBGMCU_TypeDef;

/* DMA Controller */
typedef struct
{
    __IO uint32_t CFGR;
    __IO uint32_t CNTR;
    __IO uint32_t PADDR;
    __IO uint32_t MADDR;
} DMA_Channel_TypeDef;

typedef struct
{
    __IO uint32_t INTFR;
    __IO uint32_t INTFCR;
} DMA_TypeDef;

/* External Interrupt/Event Controller */
typedef struct
{
    __IO uint32_t INTENR;
    __IO uint32_t EVENR;
    __IO uint32_t RTENR;
    __IO uint32_t FTENR;
    __IO uint32_t SWIEVR;
    __IO uint32_t INTFR;
} EXTI_TypeDef;

/* FLASH Registers */
typedef struct
{
    __IO uint32_t ACTLR;
    __IO uint32_t KEYR;
    __IO uint32_t OBKEYR;
    __IO uint32_t STATR;
    __IO uint32_t CTLR;
    __IO uint32_t ADDR;
    __IO uint32_t RESERVED;
    __IO uint32_t OBR;
    __IO uint32_t WPR;
    __IO uint32_t MODEKEYR;
    __IO uint32_t BOOT_MODEKEYR;
} FLASH_TypeDef;

/* Option Bytes Registers */
typedef struct
{
    __IO uint16_t RDPR;
    __IO uint16_t USER;
    __IO uint16_t Data0;
    __IO uint16_t Data1;
    __IO uint16_t WRPR0;
    __IO uint16_t WRPR1;
} OB_TypeDef;

/* General Purpose I/O */
typedef struct
{
    __IO uint32_t CFGLR;
    __IO uint32_t CFGHR;
    __IO uint32_t INDR;
    __IO uint32_t OUTDR;
    __IO uint32_t BSHR;
    __IO uint32_t BCR;
    __IO uint32_t LCKR;
} GPIO_TypeDef;

/* Alternate Function I/O */
typedef struct
{
    uint32_t RESERVED0;
    __IO uint32_t PCFR1;
    __IO uint32_t EXTICR;
} AFIO_TypeDef;

/* Inter Integrated Circuit Interface */
typedef struct
{
    __IO uint16_t CTLR1;
    uint16_t      RESERVED0;
    __IO uint16_t CTLR2;
    uint16_t      RESERVED1;
    __IO uint16_t OADDR1;
    uint16_t      RESERVED2;
    __IO uint16_t OADDR2;
    uint16_t      RESERVED3;
    __IO uint16_t DATAR;
    uint16_t      RESERVED4;
    __IO uint16_t STAR1;
    uint16_t      RESERVED5;
    __IO uint16_t STAR2;
    uint16_t      RESERVED6;
    __IO uint16_t CKCFGR;
    uint16_t      RESERVED7;
} I2C_TypeDef;

/* Independent WatchDog */
typedef struct
{
    __IO uint32_t CTLR;
    __IO uint32_t PSCR;
    __IO uint32_t RLDR;
    __IO uint32_t STATR;
} IWDG_TypeDef;

/* Programmable Fast Interrupt Controller (PFIC) */
typedef struct{
    __I  uint32_t ISR[8];
    __I  uint32_t IPR[8];
    __IO uint32_t ITHRESDR;
    __IO uint32_t RESERVED;
    __IO uint32_t CFGR;
    __I  uint32_t GISR;
    __IO uint8_t VTFIDR[4];
    uint8_t RESERVED0[12];
    __IO uint32_t VTFADDR[4];
    uint8_t RESERVED1[0x90];
    __O  uint32_t IENR[8];
    uint8_t RESERVED2[0x60];
    __O  uint32_t IRER[8];
    uint8_t RESERVED3[0x60];
    __O  uint32_t IPSR[8];
    uint8_t RESERVED4[0x60];
    __O  uint32_t IPRR[8];
    uint8_t RESERVED5[0x60];
    __IO uint32_t IACTR[8];
    uint8_t RESERVED6[0xE0];
    __IO uint8_t IPRIOR[256];
    uint8_t RESERVED7[0x810];
    __IO uint32_t SCTLR;
} PFIC_TypeDef;

/* Power Control */
typedef struct
{
    __IO uint32_t CTLR;
    __IO uint32_t CSR;
    __IO uint32_t AWUCSR;
    __IO uint32_t AWUWR;
    __IO uint32_t AWUPSC;
} PWR_TypeDef;

/* Reset and Clock Control */
typedef struct
{
    __IO uint32_t CTLR;
    __IO uint32_t CFGR0;
    __IO uint32_t INTR;
    __IO uint32_t APB2PRSTR;
    __IO uint32_t APB1PRSTR;
    __IO uint32_t AHBPCENR;
    __IO uint32_t APB2PCENR;
    __IO uint32_t APB1PCENR;
    __IO uint32_t RESERVED0;
    __IO uint32_t RSTSCKR;
} RCC_TypeDef;

/* Serial Peripheral Interface */
typedef struct
{
    __IO uint16_t CTLR1;
    uint16_t      RESERVED0;
    __IO uint16_t CTLR2;
    uint16_t      RESERVED1;
    __IO uint16_t STATR;
    uint16_t      RESERVED2;
    __IO uint16_t DATAR;
    uint16_t      RESERVED3;
    __IO uint16_t CRCR;
    uint16_t      RESERVED4;
    __IO uint16_t RCRCR;
    uint16_t      RESERVED5;
    __IO uint16_t TCRCR;
    uint16_t      RESERVED6;
    uint32_t      RESERVED7;
    uint32_t      RESERVED8;
    __IO uint16_t HSCR;
    uint16_t      RESERVED9;
} SPI_TypeDef;

/* System Counter (SysTick) */
typedef struct
{
    __IO uint32_t CTLR;
    __IO uint32_t SR;
    __IO uint32_t CNT;
    uint32_t RESERVED0;
    __IO uint32_t CMP;
    uint32_t RESERVED1;
} STK_TypeDef;

/* TIM */
typedef struct
{
    __IO uint16_t CTLR1;
    uint16_t      RESERVED0;
    __IO uint16_t CTLR2;
    uint16_t      RESERVED1;
    __IO uint16_t SMCFGR;
    uint16_t      RESERVED2;
    __IO uint16_t DMAINTENR;
    uint16_t      RESERVED3;
    __IO uint16_t INTFR;
    uint16_t      RESERVED4;
    __IO uint16_t SWEVGR;
    uint16_t      RESERVED5;
    __IO uint16_t CHCTLR1;
    uint16_t      RESERVED6;
    __IO uint16_t CHCTLR2;
    uint16_t      RESERVED7;
    __IO uint16_t CCER;
    uint16_t      RESERVED8;
    __IO uint16_t CNT;
    uint16_t      RESERVED9;
    __IO uint16_t PSC;
    uint16_t      RESERVED10;
    __IO uint16_t ATRLR;
    uint16_t      RESERVED11;
    __IO uint16_t RPTCR;
    uint16_t      RESERVED12;
    __IO uint32_t CH1CVR;
    __IO uint32_t CH2CVR;
    __IO uint32_t CH3CVR;
    __IO uint32_t CH4CVR;
    __IO uint16_t BDTR;
    uint16_t      RESERVED13;
    __IO uint16_t DMACFGR;
    uint16_t      RESERVED14;
    __IO uint16_t DMAADR;
    uint16_t      RESERVED15;
} TIM_TypeDef;

/* Universal Synchronous Asynchronous Receiver Transmitter */
typedef struct
{
    __IO uint16_t STATR;
    uint16_t      RESERVED0;
    __IO uint16_t DATAR;
    uint16_t      RESERVED1;
    __IO uint16_t BRR;
    uint16_t      RESERVED2;
    __IO uint16_t CTLR1;
    uint16_t      RESERVED3;
    __IO uint16_t CTLR2;
    uint16_t      RESERVED4;
    __IO uint16_t CTLR3;
    uint16_t      RESERVED5;
    __IO uint16_t GPR;
    uint16_t      RESERVED6;
} USART_TypeDef;

/* Window WatchDog */
typedef struct
{
    __IO uint32_t CTLR;
    __IO uint32_t CFGR;
    __IO uint32_t STATR;
} WWDG_TypeDef;

/* Electronic Signature */
typedef struct
{
    __IO uint16_t ESIG_FLACAP;
    uint16_t      RESERVED1;
    uint32_t      RESERVED2;
    __IO uint32_t ESIG_UNIID1;
    __IO uint32_t ESIG_UNIID2;
    __IO uint32_t ESIG_UNIID3;
} ESIG_TypeDef;

/* Extended Configuration */
typedef struct
{
    __IO uint32_t EXTEN_CTR;
} EXTEN_TypeDef;

#endif    // __ASSEMBLER__

#ifdef __ASSEMBLER__
#define FLASH_BASE                              (0x08000000) /* FLASH base address in the alias region */
#define SRAM_BASE                               (0x20000000) /* SRAM base address in the alias region */
#define PERIPH_BASE                             (0x40000000) /* Peripheral base address in the alias region */
#define OB_BASE                                 (0x1FFFF800) /* Flash Option Bytes base address */
#define ESIG_BASE                               (0x1FFFF7E0)
#define EXTEN_BASE                              (0x40023800)
#define PFIC_BASE                               (0xE000E000)
#define STK_BASE                                (0xE000F000)
#else
#define FLASH_BASE                              ((uint32_t)0x08000000) /* FLASH base address in the alias region */
#define SRAM_BASE                               ((uint32_t)0x20000000) /* SRAM base address in the alias region */
#define PERIPH_BASE                             ((uint32_t)0x40000000) /* Peripheral base address in the alias region */
#define OB_BASE                                 ((uint32_t)0x1FFFF800) /* Flash Option Bytes base address */
#define ESIG_BASE                               ((uint32_t)0x1FFFF7E0)
#define EXTEN_BASE                              ((uint32_t)0x40023800)
#define PFIC_BASE                               ((uint32_t)0xE000E000)
#define STK_BASE                                ((uint32_t)0xE000F000)
#endif

#define APB1PERIPH_BASE                         (PERIPH_BASE)
#define APB2PERIPH_BASE                         (PERIPH_BASE + 0x10000)
#define AHBPERIPH_BASE                          (PERIPH_BASE + 0x20000)

#define TIM2_BASE                               (APB1PERIPH_BASE + 0x0000)
#define WWDG_BASE                               (APB1PERIPH_BASE + 0x2C00)
#define IWDG_BASE                               (APB1PERIPH_BASE + 0x3000)
#define I2C1_BASE                               (APB1PERIPH_BASE + 0x5400)
#define PWR_BASE                                (APB1PERIPH_BASE + 0x7000)

#define AFIO_BASE                               (APB2PERIPH_BASE + 0x0000)
#define EXTI_BASE                               (APB2PERIPH_BASE + 0x0400)
#define GPIOA_BASE                              (APB2PERIPH_BASE + 0x0800)
#define GPIOC_BASE                              (APB2PERIPH_BASE + 0x1000)
#define GPIOD_BASE                              (APB2PERIPH_BASE + 0x1400)
#define ADC1_BASE                               (APB2PERIPH_BASE + 0x2400)
#define TIM1_BASE                               (APB2PERIPH_BASE + 0x2C00)
#define SPI1_BASE                               (APB2PERIPH_BASE + 0x3000)
#define USART1_BASE                             (APB2PERIPH_BASE + 0x3800)

#define DMA1_BASE                               (AHBPERIPH_BASE + 0x0000)
#define DMA1_Channel1_BASE                      (AHBPERIPH_BASE + 0x0008)
#define DMA1_Channel2_BASE                      (AHBPERIPH_BASE + 0x001C)
#define DMA1_Channel3_BASE                      (AHBPERIPH_BASE + 0x0030)
#define DMA1_Channel4_BASE                      (AHBPERIPH_BASE + 0x0044)
#define DMA1_Channel5_BASE                      (AHBPERIPH_BASE + 0x0058)
#define DMA1_Channel6_BASE                      (AHBPERIPH_BASE + 0x006C)
#define DMA1_Channel7_BASE                      (AHBPERIPH_BASE + 0x0080)
#define RCC_BASE                                (AHBPERIPH_BASE + 0x1000)
#define FLASH_R_BASE                            (AHBPERIPH_BASE + 0x2000) /* Flash registers base address */

/* Peripheral declaration */
#define TIM2                                    ((TIM_TypeDef *)TIM2_BASE)
#define WWDG                                    ((WWDG_TypeDef *)WWDG_BASE)
#define IWDG                                    ((IWDG_TypeDef *)IWDG_BASE)
#define I2C1                                    ((I2C_TypeDef *)I2C1_BASE)
#define PWR                                     ((PWR_TypeDef *)PWR_BASE)
#define AFIO                                    ((AFIO_TypeDef *)AFIO_BASE)
#define EXTI                                    ((EXTI_TypeDef *)EXTI_BASE)
#define GPIOA                                   ((GPIO_TypeDef *)GPIOA_BASE)
#define GPIOC                                   ((GPIO_TypeDef *)GPIOC_BASE)
#define GPIOD                                   ((GPIO_TypeDef *)GPIOD_BASE)
#define ADC1                                    ((ADC_TypeDef *)ADC1_BASE)
#define TIM1                                    ((TIM_TypeDef *)TIM1_BASE)
#define SPI1                                    ((SPI_TypeDef *)SPI1_BASE)
#define USART1                                  ((USART_TypeDef *)USART1_BASE)
#define DMA1                                    ((DMA_TypeDef *)DMA1_BASE)
#define DMA1_Channel1                           ((DMA_Channel_TypeDef *)DMA1_Channel1_BASE)
#define DMA1_Channel2                           ((DMA_Channel_TypeDef *)DMA1_Channel2_BASE)
#define DMA1_Channel3                           ((DMA_Channel_TypeDef *)DMA1_Channel3_BASE)
#define DMA1_Channel4                           ((DMA_Channel_TypeDef *)DMA1_Channel4_BASE)
#define DMA1_Channel5                           ((DMA_Channel_TypeDef *)DMA1_Channel5_BASE)
#define DMA1_Channel6                           ((DMA_Channel_TypeDef *)DMA1_Channel6_BASE)
#define DMA1_Channel7                           ((DMA_Channel_TypeDef *)DMA1_Channel7_BASE)
#define RCC                                     ((RCC_TypeDef *)RCC_BASE)
#define FLASH                                   ((FLASH_TypeDef *)FLASH_R_BASE)
#define OB                                      ((OB_TypeDef *)OB_BASE)
#define ESIG                                    ((ESIG_TypeDef *)ESIG_BASE)
#define EXTEN                                   ((EXTEN_TypeDef *)EXTEN_BASE)

#define PFIC                                    ((PFIC_TypeDef *)PFIC_BASE)
#define STK                                     ((STK_TypeDef *)STK_BASE)

#define NVIC                                    PFIC
#define SysTick                                 STK
#define SYSTICK                                 STK

/******************************************************************************/
/*                         Peripheral Registers Bits Definition               */
/******************************************************************************/

/******************************************************************************/
/*                        Analog to Digital Converter                         */
/******************************************************************************/

/********************  Bit definition for ADC_STATR register  ********************/
#define ADC_AWD                                 ((uint8_t)0x01) /* Analog watchdog flag */
#define ADC_EOC                                 ((uint8_t)0x02) /* End of conversion */
#define ADC_JEOC                                ((uint8_t)0x04) /* Injected channel end of conversion */
#define ADC_JSTRT                               ((uint8_t)0x08) /* Injected channel Start flag */
#define ADC_STRT                                ((uint8_t)0x10) /* Regular channel Start flag */

/*******************  Bit definition for ADC_CTLR1 register  ********************/
#define ADC_AWDCH                               ((uint32_t)0x0000001F) /* AWDCH[4:0] bits (Analog watchdog channel select bits) */
#define ADC_AWDCH_0                             ((uint32_t)0x00000001) /* Bit 0 */
#define ADC_AWDCH_1                             ((uint32_t)0x00000002) /* Bit 1 */
#define ADC_AWDCH_2                             ((uint32_t)0x00000004) /* Bit 2 */
#define ADC_AWDCH_3                             ((uint32_t)0x00000008) /* Bit 3 */
#define ADC_AWDCH_4                             ((uint32_t)0x00000010) /* Bit 4 */

#define ADC_EOCIE                               ((uint32_t)0x00000020) /* Interrupt enable for EOC */
#define ADC_AWDIE                               ((uint32_t)0x00000040) /* Analog Watchdog interrupt enable */
#define ADC_JEOCIE                              ((uint32_t)0x00000080) /* Interrupt enable for injected channels */
#define ADC_SCAN                                ((uint32_t)0x00000100) /* Scan mode */
#define ADC_AWDSGL                              ((uint32_t)0x00000200) /* Enable the watchdog on a single channel in scan mode */
#define ADC_JAUTO                               ((uint32_t)0x00000400) /* Automatic injected group conversion */
#define ADC_DISCEN                              ((uint32_t)0x00000800) /* Discontinuous mode on regular channels */
#define ADC_JDISCEN                             ((uint32_t)0x00001000) /* Discontinuous mode on injected channels */

#define ADC_DISCNUM                             ((uint32_t)0x0000E000) /* DISCNUM[2:0] bits (Discontinuous mode channel count) */
#define ADC_DISCNUM_0                           ((uint32_t)0x00002000) /* Bit 0 */
#define ADC_DISCNUM_1                           ((uint32_t)0x00004000) /* Bit 1 */
#define ADC_DISCNUM_2                           ((uint32_t)0x00008000) /* Bit 2 */

#define ADC_DUALMOD                             ((uint32_t)0x000F0000) /* DUALMOD[3:0] bits (Dual mode selection) */
#define ADC_DUALMOD_0                           ((uint32_t)0x00010000) /* Bit 0 */
#define ADC_DUALMOD_1                           ((uint32_t)0x00020000) /* Bit 1 */
#define ADC_DUALMOD_2                           ((uint32_t)0x00040000) /* Bit 2 */
#define ADC_DUALMOD_3                           ((uint32_t)0x00080000) /* Bit 3 */

#define ADC_JAWDEN                              ((uint32_t)0x00400000) /* Analog watchdog enable on injected channels */
#define ADC_AWDEN                               ((uint32_t)0x00800000) /* Analog watchdog enable on regular channels */
#define ADC_CALVOLSELECT                        ((uint32_t)0x06000000) /* CALVOL[1:0] calibration voltage selection */
#define ADC_CALVOLSELECT_0                      ((uint32_t)0x02000000) /* 01: 2/4 AVDD */
#define ADC_CALVOLSELECT_1                      ((uint32_t)0x04000000) /* 10: 3/4 AVDD */

/*******************  Bit definition for ADC_CTLR2 register  ********************/
#define ADC_ADON                                ((uint32_t)0x00000001) /* A/D Converter ON / OFF */
#define ADC_CONT                                ((uint32_t)0x00000002) /* Continuous Conversion */
#define ADC_CAL                                 ((uint32_t)0x00000004) /* A/D Calibration */
#define ADC_RSTCAL                              ((uint32_t)0x00000008) /* Reset Calibration */
#define ADC_DMA                                 ((uint32_t)0x00000100) /* Direct Memory access mode */
#define ADC_ALIGN                               ((uint32_t)0x00000800) /* Data Alignment */

#define ADC_JEXTSEL                             ((uint32_t)0x00007000) /* JEXTSEL[2:0] bits (External event select for injected group) */
#define ADC_JEXTSEL_0                           ((uint32_t)0x00001000) /* Bit 0 */
#define ADC_JEXTSEL_1                           ((uint32_t)0x00002000) /* Bit 1 */
#define ADC_JEXTSEL_2                           ((uint32_t)0x00004000) /* Bit 2 */

#define ADC_JEXTTRIG                            ((uint32_t)0x00008000) /* External Trigger Conversion mode for injected channels */

#define ADC_EXTSEL                              ((uint32_t)0x000E0000) /* EXTSEL[2:0] bits (External Event Select for regular group) */
#define ADC_EXTSEL_0                            ((uint32_t)0x00020000) /* Bit 0 */
#define ADC_EXTSEL_1                            ((uint32_t)0x00040000) /* Bit 1 */
#define ADC_EXTSEL_2                            ((uint32_t)0x00080000) /* Bit 2 */

#define ADC_EXTTRIG                             ((uint32_t)0x00100000) /* External Trigger Conversion mode for regular channels */
#define ADC_JSWSTART                            ((uint32_t)0x00200000) /* Start Conversion of injected channels */
#define ADC_SWSTART                             ((uint32_t)0x00400000) /* Start Conversion of regular channels */
#define ADC_TSVREFE                             ((uint32_t)0x00800000) /* Temperature Sensor and VREFINT Enable */

/******************  Bit definition for ADC_SAMPTR1 register  *******************/
#define ADC_SMP10                               ((uint32_t)0x00000007) /* SMP10[2:0] bits (Channel 10 Sample time selection) */
#define ADC_SMP10_0                             ((uint32_t)0x00000001) /* Bit 0 */
#define ADC_SMP10_1                             ((uint32_t)0x00000002) /* Bit 1 */
#define ADC_SMP10_2                             ((uint32_t)0x00000004) /* Bit 2 */

#define ADC_SMP11                               ((uint32_t)0x00000038) /* SMP11[2:0] bits (Channel 11 Sample time selection) */
#define ADC_SMP11_0                             ((uint32_t)0x00000008) /* Bit 0 */
#define ADC_SMP11_1                             ((uint32_t)0x00000010) /* Bit 1 */
#define ADC_SMP11_2                             ((uint32_t)0x00000020) /* Bit 2 */

#define ADC_SMP12                               ((uint32_t)0x000001C0) /* SMP12[2:0] bits (Channel 12 Sample time selection) */
#define ADC_SMP12_0                             ((uint32_t)0x00000040) /* Bit 0 */
#define ADC_SMP12_1                             ((uint32_t)0x00000080) /* Bit 1 */
#define ADC_SMP12_2                             ((uint32_t)0x00000100) /* Bit 2 */

#define ADC_SMP13                               ((uint32_t)0x00000E00) /* SMP13[2:0] bits (Channel 13 Sample time selection) */
#define ADC_SMP13_0                             ((uint32_t)0x00000200) /* Bit 0 */
#define ADC_SMP13_1                             ((uint32_t)0x00000400) /* Bit 1 */
#define ADC_SMP13_2                             ((uint32_t)0x00000800) /* Bit 2 */

#define ADC_SMP14                               ((uint32_t)0x00007000) /* SMP14[2:0] bits (Channel 14 Sample time selection) */
#define ADC_SMP14_0                             ((uint32_t)0x00001000) /* Bit 0 */
#define ADC_SMP14_1                             ((uint32_t)0x00002000) /* Bit 1 */
#define ADC_SMP14_2                             ((uint32_t)0x00004000) /* Bit 2 */

#define ADC_SMP15                               ((uint32_t)0x00038000) /* SMP15[2:0] bits (Channel 15 Sample time selection) */
#define ADC_SMP15_0                             ((uint32_t)0x00008000) /* Bit 0 */
#define ADC_SMP15_1                             ((uint32_t)0x00010000) /* Bit 1 */
#define ADC_SMP15_2                             ((uint32_t)0x00020000) /* Bit 2 */

#define ADC_SMP16                               ((uint32_t)0x001C0000) /* SMP16[2:0] bits (Channel 16 Sample time selection) */
#define ADC_SMP16_0                             ((uint32_t)0x00040000) /* Bit 0 */
#define ADC_SMP16_1                             ((uint32_t)0x00080000) /* Bit 1 */
#define ADC_SMP16_2                             ((uint32_t)0x00100000) /* Bit 2 */

#define ADC_SMP17                               ((uint32_t)0x00E00000) /* SMP17[2:0] bits (Channel 17 Sample time selection) */
#define ADC_SMP17_0                             ((uint32_t)0x00200000) /* Bit 0 */
#define ADC_SMP17_1                             ((uint32_t)0x00400000) /* Bit 1 */
#define ADC_SMP17_2                             ((uint32_t)0x00800000) /* Bit 2 */

/******************  Bit definition for ADC_SAMPTR2 register  *******************/
#define ADC_SMP0                                ((uint32_t)0x00000007) /* SMP0[2:0] bits (Channel 0 Sample time selection) */
#define ADC_SMP0_0                              ((uint32_t)0x00000001) /* Bit 0 */
#define ADC_SMP0_1                              ((uint32_t)0x00000002) /* Bit 1 */
#define ADC_SMP0_2                              ((uint32_t)0x00000004) /* Bit 2 */

#define ADC_SMP1                                ((uint32_t)0x00000038) /* SMP1[2:0] bits (Channel 1 Sample time selection) */
#define ADC_SMP1_0                              ((uint32_t)0x00000008) /* Bit 0 */
#define ADC_SMP1_1                              ((uint32_t)0x00000010) /* Bit 1 */
#define ADC_SMP1_2                              ((uint32_t)0x00000020) /* Bit 2 */

#define ADC_SMP2                                ((uint32_t)0x000001C0) /* SMP2[2:0] bits (Channel 2 Sample time selection) */
#define ADC_SMP2_0                              ((uint32_t)0x00000040) /* Bit 0 */
#define ADC_SMP2_1                              ((uint32_t)0x00000080) /* Bit 1 */
#define ADC_SMP2_2                              ((uint32_t)0x00000100) /* Bit 2 */

#define ADC_SMP3                                ((uint32_t)0x00000E00) /* SMP3[2:0] bits (Channel 3 Sample time selection) */
#define ADC_SMP3_0                              ((uint32_t)0x00000200) /* Bit 0 */
#define ADC_SMP3_1                              ((uint32_t)0x00000400) /* Bit 1 */
#define ADC_SMP3_2                              ((uint32_t)0x00000800) /* Bit 2 */

#define ADC_SMP4                                ((uint32_t)0x00007000) /* SMP4[2:0] bits (Channel 4 Sample time selection) */
#define ADC_SMP4_0                              ((uint32_t)0x00001000) /* Bit 0 */
#define ADC_SMP4_1                              ((uint32_t)0x00002000) /* Bit 1 */
#define ADC_SMP4_2                              ((uint32_t)0x00004000) /* Bit 2 */

#define ADC_SMP5                                ((uint32_t)0x00038000) /* SMP5[2:0] bits (Channel 5 Sample time selection) */
#define ADC_SMP5_0                              ((uint32_t)0x00008000) /* Bit 0 */
#define ADC_SMP5_1                              ((uint32_t)0x00010000) /* Bit 1 */
#define ADC_SMP5_2                              ((uint32_t)0x00020000) /* Bit 2 */

#define ADC_SMP6                                ((uint32_t)0x001C0000) /* SMP6[2:0] bits (Channel 6 Sample time selection) */
#define ADC_SMP6_0                              ((uint32_t)0x00040000) /* Bit 0 */
#define ADC_SMP6_1                              ((uint32_t)0x00080000) /* Bit 1 */
#define ADC_SMP6_2                              ((uint32_t)0x00100000) /* Bit 2 */

#define ADC_SMP7                                ((uint32_t)0x00E00000) /* SMP7[2:0] bits (Channel 7 Sample time selection) */
#define ADC_SMP7_0                              ((uint32_t)0x00200000) /* Bit 0 */
#define ADC_SMP7_1                              ((uint32_t)0x00400000) /* Bit 1 */
#define ADC_SMP7_2                              ((uint32_t)0x00800000) /* Bit 2 */

#define ADC_SMP8                                ((uint32_t)0x07000000) /* SMP8[2:0] bits (Channel 8 Sample time selection) */
#define ADC_SMP8_0                              ((uint32_t)0x01000000) /* Bit 0 */
#define ADC_SMP8_1                              ((uint32_t)0x02000000) /* Bit 1 */
#define ADC_SMP8_2                              ((uint32_t)0x04000000) /* Bit 2 */

#define ADC_SMP9                                ((uint32_t)0x38000000) /* SMP9[2:0] bits (Channel 9 Sample time selection) */
#define ADC_SMP9_0                              ((uint32_t)0x08000000) /* Bit 0 */
#define ADC_SMP9_1                              ((uint32_t)0x10000000) /* Bit 1 */
#define ADC_SMP9_2                              ((uint32_t)0x20000000) /* Bit 2 */

/******************  Bit definition for ADC_IOFR1 register  *******************/
#define ADC_JOFFSET1                            ((uint16_t)0x03FF) /* Data offset for injected channel 1 */

/******************  Bit definition for ADC_IOFR2 register  *******************/
#define ADC_JOFFSET2                            ((uint16_t)0x03FF) /* Data offset for injected channel 2 */

/******************  Bit definition for ADC_IOFR3 register  *******************/
#define ADC_JOFFSET3                            ((uint16_t)0x03FF) /* Data offset for injected channel 3 */

/******************  Bit definition for ADC_IOFR4 register  *******************/
#define ADC_JOFFSET4                            ((uint16_t)0x03FF) /* Data offset for injected channel 4 */

/*******************  Bit definition for ADC_WDHTR register  ********************/
#define ADC_HT                                  ((uint16_t)0x03FF) /* Analog watchdog high threshold */

/*******************  Bit definition for ADC_WDLTR register  ********************/
#define ADC_LT                                  ((uint16_t)0x03FF) /* Analog watchdog low threshold */

/*******************  Bit definition for ADC_RSQR1 register  *******************/
#define ADC_SQ13                                ((uint32_t)0x0000001F) /* SQ13[4:0] bits (13th conversion in regular sequence) */
#define ADC_SQ13_0                              ((uint32_t)0x00000001) /* Bit 0 */
#define ADC_SQ13_1                              ((uint32_t)0x00000002) /* Bit 1 */
#define ADC_SQ13_2                              ((uint32_t)0x00000004) /* Bit 2 */
#define ADC_SQ13_3                              ((uint32_t)0x00000008) /* Bit 3 */
#define ADC_SQ13_4                              ((uint32_t)0x00000010) /* Bit 4 */

#define ADC_SQ14                                ((uint32_t)0x000003E0) /* SQ14[4:0] bits (14th conversion in regular sequence) */
#define ADC_SQ14_0                              ((uint32_t)0x00000020) /* Bit 0 */
#define ADC_SQ14_1                              ((uint32_t)0x00000040) /* Bit 1 */
#define ADC_SQ14_2                              ((uint32_t)0x00000080) /* Bit 2 */
#define ADC_SQ14_3                              ((uint32_t)0x00000100) /* Bit 3 */
#define ADC_SQ14_4                              ((uint32_t)0x00000200) /* Bit 4 */

#define ADC_SQ15                                ((uint32_t)0x00007C00) /* SQ15[4:0] bits (15th conversion in regular sequence) */
#define ADC_SQ15_0                              ((uint32_t)0x00000400) /* Bit 0 */
#define ADC_SQ15_1                              ((uint32_t)0x00000800) /* Bit 1 */
#define ADC_SQ15_2                              ((uint32_t)0x00001000) /* Bit 2 */
#define ADC_SQ15_3                              ((uint32_t)0x00002000) /* Bit 3 */
#define ADC_SQ15_4                              ((uint32_t)0x00004000) /* Bit 4 */

#define ADC_SQ16                                ((uint32_t)0x000F8000) /* SQ16[4:0] bits (16th conversion in regular sequence) */
#define ADC_SQ16_0                              ((uint32_t)0x00008000) /* Bit 0 */
#define ADC_SQ16_1                              ((uint32_t)0x00010000) /* Bit 1 */
#define ADC_SQ16_2                              ((uint32_t)0x00020000) /* Bit 2 */
#define ADC_SQ16_3                              ((uint32_t)0x00040000) /* Bit 3 */
#define ADC_SQ16_4                              ((uint32_t)0x00080000) /* Bit 4 */

#define ADC_L                                   ((uint32_t)0x00F00000) /* L[3:0] bits (Regular channel sequence length) */
#define ADC_L_0                                 ((uint32_t)0x00100000) /* Bit 0 */
#define ADC_L_1                                 ((uint32_t)0x00200000) /* Bit 1 */
#define ADC_L_2                                 ((uint32_t)0x00400000) /* Bit 2 */
#define ADC_L_3                                 ((uint32_t)0x00800000) /* Bit 3 */

/*******************  Bit definition for ADC_RSQR2 register  *******************/
#define ADC_SQ7                                 ((uint32_t)0x0000001F) /* SQ7[4:0] bits (7th conversion in regular sequence) */
#define ADC_SQ7_0                               ((uint32_t)0x00000001) /* Bit 0 */
#define ADC_SQ7_1                               ((uint32_t)0x00000002) /* Bit 1 */
#define ADC_SQ7_2                               ((uint32_t)0x00000004) /* Bit 2 */
#define ADC_SQ7_3                               ((uint32_t)0x00000008) /* Bit 3 */
#define ADC_SQ7_4                               ((uint32_t)0x00000010) /* Bit 4 */

#define ADC_SQ8                                 ((uint32_t)0x000003E0) /* SQ8[4:0] bits (8th conversion in regular sequence) */
#define ADC_SQ8_0                               ((uint32_t)0x00000020) /* Bit 0 */
#define ADC_SQ8_1                               ((uint32_t)0x00000040) /* Bit 1 */
#define ADC_SQ8_2                               ((uint32_t)0x00000080) /* Bit 2 */
#define ADC_SQ8_3                               ((uint32_t)0x00000100) /* Bit 3 */
#define ADC_SQ8_4                               ((uint32_t)0x00000200) /* Bit 4 */

#define ADC_SQ9                                 ((uint32_t)0x00007C00) /* SQ9[4:0] bits (9th conversion in regular sequence) */
#define ADC_SQ9_0                               ((uint32_t)0x00000400) /* Bit 0 */
#define ADC_SQ9_1                               ((uint32_t)0x00000800) /* Bit 1 */
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
#define ADC_SQ4_2                               ((uint32_t)0x00020000) /* Bit 2 */
#define ADC_SQ4_3                               ((uint32_t)0x00040000) /* Bit 3 */
#define ADC_SQ4_4                               ((uint32_t)0x00080000) /* Bit 4 */

#define ADC_SQ5                                 ((uint32_t)0x01F00000) /* SQ5[4:0] bits (5th conversion in regular sequence) */
#define ADC_SQ5_0                               ((uint32_t)0x00100000) /* Bit 0 */
#define ADC_SQ5_1                               ((uint32_t)0x00200000) /* Bit 1 */
#define ADC_SQ5_2                               ((uint32_t)0x00400000) /* Bit 2 */
#define ADC_SQ5_3                               ((uint32_t)0x00800000) /* Bit 3 */
#define ADC_SQ5_4                               ((uint32_t)0x01000000) /* Bit 4 */

#define ADC_SQ6                                 ((uint32_t)0x3E000000) /* SQ6[4:0] bits (6th conversion in regular sequence) */
#define ADC_SQ6_0                               ((uint32_t)0x02000000) /* Bit 0 */
#define ADC_SQ6_1                               ((uint32_t)0x04000000) /* Bit 1 */
#define ADC_SQ6_2                               ((uint32_t)0x08000000) /* Bit 2 */
#define ADC_SQ6_3                               ((uint32_t)0x10000000) /* Bit 3 */
#define ADC_SQ6_4                               ((uint32_t)0x20000000) /* Bit 4 */

/*******************  Bit definition for ADC_ISQR register  *******************/
#define ADC_JSQ1                                ((uint32_t)0x0000001F) /* JSQ1[4:0] bits (1st conversion in injected sequence) */
#define ADC_JSQ1_0                              ((uint32_t)0x00000001) /* Bit 0 */
#define ADC_JSQ1_1                              ((uint32_t)0x00000002) /* Bit 1 */
#define ADC_JSQ1_2                              ((uint32_t)0x00000004) /* Bit 2 */
#define ADC_JSQ1_3                              ((uint32_t)0x00000008) /* Bit 3 */
#define ADC_JSQ1_4                              ((uint32_t)0x00000010) /* Bit 4 */

#define ADC_JSQ2                                ((uint32_t)0x000003E0) /* JSQ2[4:0] bits (2nd conversion in injected sequence) */
#define ADC_JSQ2_0                              ((uint32_t)0x00000020) /* Bit 0 */
#define ADC_JSQ2_1                              ((uint32_t)0x00000040) /* Bit 1 */
#define ADC_JSQ2_2                              ((uint32_t)0x00000080) /* Bit 2 */
#define ADC_JSQ2_3                              ((uint32_t)0x00000100) /* Bit 3 */
#define ADC_JSQ2_4                              ((uint32_t)0x00000200) /* Bit 4 */

#define ADC_JSQ3                                ((uint32_t)0x00007C00) /* JSQ3[4:0] bits (3rd conversion in injected sequence) */
#define ADC_JSQ3_0                              ((uint32_t)0x00000400) /* Bit 0 */
#define ADC_JSQ3_1                              ((uint32_t)0x00000800) /* Bit 1 */
#define ADC_JSQ3_2                              ((uint32_t)0x00001000) /* Bit 2 */
#define ADC_JSQ3_3                              ((uint32_t)0x00002000) /* Bit 3 */
#define ADC_JSQ3_4                              ((uint32_t)0x00004000) /* Bit 4 */

#define ADC_JSQ4                                ((uint32_t)0x000F8000) /* JSQ4[4:0] bits (4th conversion in injected sequence) */
#define ADC_JSQ4_0                              ((uint32_t)0x00008000) /* Bit 0 */
#define ADC_JSQ4_1                              ((uint32_t)0x00010000) /* Bit 1 */
#define ADC_JSQ4_2                              ((uint32_t)0x00020000) /* Bit 2 */
#define ADC_JSQ4_3                              ((uint32_t)0x00040000) /* Bit 3 */
#define ADC_JSQ4_4                              ((uint32_t)0x00080000) /* Bit 4 */

#define ADC_JL                                  ((uint32_t)0x00300000) /* JL[1:0] bits (Injected Sequence length) */
#define ADC_JL_0                                ((uint32_t)0x00100000) /* Bit 0 */
#define ADC_JL_1                                ((uint32_t)0x00200000) /* Bit 1 */

/*******************  Bit definition for ADC_IDATAR1 register  *******************/
#define ADC_IDATAR1_JDATA                       ((uint16_t)0xFFFF) /* Injected data */

/*******************  Bit definition for ADC_IDATAR2 register  *******************/
#define ADC_IDATAR2_JDATA                       ((uint16_t)0xFFFF) /* Injected data */

/*******************  Bit definition for ADC_IDATAR3 register  *******************/
#define ADC_IDATAR3_JDATA                       ((uint16_t)0xFFFF) /* Injected data */

/*******************  Bit definition for ADC_IDATAR4 register  *******************/
#define ADC_IDATAR4_JDATA                       ((uint16_t)0xFFFF) /* Injected data */

/********************  Bit definition for ADC_RDATAR register  ********************/
#define ADC_RDATAR_DATA                         ((uint32_t)0x0000FFFF) /* Regular data */

/********************  Bit definition for ADC_DLYR register  ********************/
#define ADC_DLYR_DLYVLU                         ((uint32_t)0x000001FF) /* External trigger delay (ADC clock cycles) */
#define ADC_DLYR_DLYSRC                         ((uint32_t)0x00000200) /* Delay source: 1: injected, 0: regular */
#define ADC_RDATAR_ADC2DATA                     ((uint32_t)0xFFFF0000) /* ADC2 data */

/******************************************************************************/
/*                             DMA Controller                                 */
/******************************************************************************/

/*******************  Bit definition for DMA_INTFR register  ********************/
#define DMA_GIF1                                ((uint32_t)0x00000001) /* Channel 1 Global interrupt flag */
#define DMA_TCIF1                               ((uint32_t)0x00000002) /* Channel 1 Transfer Complete flag */
#define DMA_HTIF1                               ((uint32_t)0x00000004) /* Channel 1 Half Transfer flag */
#define DMA_TEIF1                               ((uint32_t)0x00000008) /* Channel 1 Transfer Error flag */
#define DMA_GIF2                                ((uint32_t)0x00000010) /* Channel 2 Global interrupt flag */
#define DMA_TCIF2                               ((uint32_t)0x00000020) /* Channel 2 Transfer Complete flag */
#define DMA_HTIF2                               ((uint32_t)0x00000040) /* Channel 2 Half Transfer flag */
#define DMA_TEIF2                               ((uint32_t)0x00000080) /* Channel 2 Transfer Error flag */
#define DMA_GIF3                                ((uint32_t)0x00000100) /* Channel 3 Global interrupt flag */
#define DMA_TCIF3                               ((uint32_t)0x00000200) /* Channel 3 Transfer Complete flag */
#define DMA_HTIF3                               ((uint32_t)0x00000400) /* Channel 3 Half Transfer flag */
#define DMA_TEIF3                               ((uint32_t)0x00000800) /* Channel 3 Transfer Error flag */
#define DMA_GIF4                                ((uint32_t)0x00001000) /* Channel 4 Global interrupt flag */
#define DMA_TCIF4                               ((uint32_t)0x00002000) /* Channel 4 Transfer Complete flag */
#define DMA_HTIF4                               ((uint32_t)0x00004000) /* Channel 4 Half Transfer flag */
#define DMA_TEIF4                               ((uint32_t)0x00008000) /* Channel 4 Transfer Error flag */
#define DMA_GIF5                                ((uint32_t)0x00010000) /* Channel 5 Global interrupt flag */
#define DMA_TCIF5                               ((uint32_t)0x00020000) /* Channel 5 Transfer Complete flag */
#define DMA_HTIF5                               ((uint32_t)0x00040000) /* Channel 5 Half Transfer flag */
#define DMA_TEIF5                               ((uint32_t)0x00080000) /* Channel 5 Transfer Error flag */
#define DMA_GIF6                                ((uint32_t)0x00100000) /* Channel 6 Global interrupt flag */
#define DMA_TCIF6                               ((uint32_t)0x00200000) /* Channel 6 Transfer Complete flag */
#define DMA_HTIF6                               ((uint32_t)0x00400000) /* Channel 6 Half Transfer flag */
#define DMA_TEIF6                               ((uint32_t)0x00800000) /* Channel 6 Transfer Error flag */
#define DMA_GIF7                                ((uint32_t)0x01000000) /* Channel 7 Global interrupt flag */
#define DMA_TCIF7                               ((uint32_t)0x02000000) /* Channel 7 Transfer Complete flag */
#define DMA_HTIF7                               ((uint32_t)0x04000000) /* Channel 7 Half Transfer flag */
#define DMA_TEIF7                               ((uint32_t)0x08000000) /* Channel 7 Transfer Error flag */

/*******************  Bit definition for DMA_INTFCR register  *******************/
#define DMA_CGIF1                               ((uint32_t)0x00000001) /* Channel 1 Global interrupt clear */
#define DMA_CTCIF1                              ((uint32_t)0x00000002) /* Channel 1 Transfer Complete clear */
#define DMA_CHTIF1                              ((uint32_t)0x00000004) /* Channel 1 Half Transfer clear */
#define DMA_CTEIF1                              ((uint32_t)0x00000008) /* Channel 1 Transfer Error clear */
#define DMA_CGIF2                               ((uint32_t)0x00000010) /* Channel 2 Global interrupt clear */
#define DMA_CTCIF2                              ((uint32_t)0x00000020) /* Channel 2 Transfer Complete clear */
#define DMA_CHTIF2                              ((uint32_t)0x00000040) /* Channel 2 Half Transfer clear */
#define DMA_CTEIF2                              ((uint32_t)0x00000080) /* Channel 2 Transfer Error clear */
#define DMA_CGIF3                               ((uint32_t)0x00000100) /* Channel 3 Global interrupt clear */
#define DMA_CTCIF3                              ((uint32_t)0x00000200) /* Channel 3 Transfer Complete clear */
#define DMA_CHTIF3                              ((uint32_t)0x00000400) /* Channel 3 Half Transfer clear */
#define DMA_CTEIF3                              ((uint32_t)0x00000800) /* Channel 3 Transfer Error clear */
#define DMA_CGIF4                               ((uint32_t)0x00001000) /* Channel 4 Global interrupt clear */
#define DMA_CTCIF4                              ((uint32_t)0x00002000) /* Channel 4 Transfer Complete clear */
#define DMA_CHTIF4                              ((uint32_t)0x00004000) /* Channel 4 Half Transfer clear */
#define DMA_CTEIF4                              ((uint32_t)0x00008000) /* Channel 4 Transfer Error clear */
#define DMA_CGIF5                               ((uint32_t)0x00010000) /* Channel 5 Global interrupt clear */
#define DMA_CTCIF5                              ((uint32_t)0x00020000) /* Channel 5 Transfer Complete clear */
#define DMA_CHTIF5                              ((uint32_t)0x00040000) /* Channel 5 Half Transfer clear */
#define DMA_CTEIF5                              ((uint32_t)0x00080000) /* Channel 5 Transfer Error clear */
#define DMA_CGIF6                               ((uint32_t)0x00100000) /* Channel 6 Global interrupt clear */
#define DMA_CTCIF6                              ((uint32_t)0x00200000) /* Channel 6 Transfer Complete clear */
#define DMA_CHTIF6                              ((uint32_t)0x00400000) /* Channel 6 Half Transfer clear */
#define DMA_CTEIF6                              ((uint32_t)0x00800000) /* Channel 6 Transfer Error clear */
#define DMA_CGIF7                               ((uint32_t)0x01000000) /* Channel 7 Global interrupt clear */
#define DMA_CTCIF7                              ((uint32_t)0x02000000) /* Channel 7 Transfer Complete clear */
#define DMA_CHTIF7                              ((uint32_t)0x04000000) /* Channel 7 Half Transfer clear */
#define DMA_CTEIF7                              ((uint32_t)0x08000000) /* Channel 7 Transfer Error clear */

/*******************  Bit definition for DMA_CFGR1 register  *******************/
#define DMA_CFGR1_EN                            ((uint16_t)0x0001) /* Channel enable*/
#define DMA_CFGR1_TCIE                          ((uint16_t)0x0002) /* Transfer complete interrupt enable */
#define DMA_CFGR1_HTIE                          ((uint16_t)0x0004) /* Half Transfer interrupt enable */
#define DMA_CFGR1_TEIE                          ((uint16_t)0x0008) /* Transfer error interrupt enable */
#define DMA_CFGR1_DIR                           ((uint16_t)0x0010) /* Data transfer direction */
#define DMA_CFGR1_CIRC                          ((uint16_t)0x0020) /* Circular mode */
#define DMA_CFGR1_PINC                          ((uint16_t)0x0040) /* Peripheral increment mode */
#define DMA_CFGR1_MINC                          ((uint16_t)0x0080) /* Memory increment mode */

#define DMA_CFGR1_PSIZE                         ((uint16_t)0x0300) /* PSIZE[1:0] bits (Peripheral size) */
#define DMA_CFGR1_PSIZE_0                       ((uint16_t)0x0100) /* Bit 0 */
#define DMA_CFGR1_PSIZE_1                       ((uint16_t)0x0200) /* Bit 1 */

#define DMA_CFGR1_MSIZE                         ((uint16_t)0x0C00) /* MSIZE[1:0] bits (Memory size) */
#define DMA_CFGR1_MSIZE_0                       ((uint16_t)0x0400) /* Bit 0 */
#define DMA_CFGR1_MSIZE_1                       ((uint16_t)0x0800) /* Bit 1 */

#define DMA_CFGR1_PL                            ((uint16_t)0x3000) /* PL[1:0] bits(Channel Priority level) */
#define DMA_CFGR1_PL_0                          ((uint16_t)0x1000) /* Bit 0 */
#define DMA_CFGR1_PL_1                          ((uint16_t)0x2000) /* Bit 1 */

#define DMA_CFGR1_MEM2MEM                       ((uint16_t)0x4000) /* Memory to memory mode */

/*******************  Bit definition for DMA_CFGR2 register  *******************/
#define DMA_CFGR2_EN                            ((uint16_t)0x0001) /* Channel enable */
#define DMA_CFGR2_TCIE                          ((uint16_t)0x0002) /* Transfer complete interrupt enable */
#define DMA_CFGR2_HTIE                          ((uint16_t)0x0004) /* Half Transfer interrupt enable */
#define DMA_CFGR2_TEIE                          ((uint16_t)0x0008) /* Transfer error interrupt enable */
#define DMA_CFGR2_DIR                           ((uint16_t)0x0010) /* Data transfer direction */
#define DMA_CFGR2_CIRC                          ((uint16_t)0x0020) /* Circular mode */
#define DMA_CFGR2_PINC                          ((uint16_t)0x0040) /* Peripheral increment mode */
#define DMA_CFGR2_MINC                          ((uint16_t)0x0080) /* Memory increment mode */

#define DMA_CFGR2_PSIZE                         ((uint16_t)0x0300) /* PSIZE[1:0] bits (Peripheral size) */
#define DMA_CFGR2_PSIZE_0                       ((uint16_t)0x0100) /* Bit 0 */
#define DMA_CFGR2_PSIZE_1                       ((uint16_t)0x0200) /* Bit 1 */

#define DMA_CFGR2_MSIZE                         ((uint16_t)0x0C00) /* MSIZE[1:0] bits (Memory size) */
#define DMA_CFGR2_MSIZE_0                       ((uint16_t)0x0400) /* Bit 0 */
#define DMA_CFGR2_MSIZE_1                       ((uint16_t)0x0800) /* Bit 1 */

#define DMA_CFGR2_PL                            ((uint16_t)0x3000) /* PL[1:0] bits (Channel Priority level) */
#define DMA_CFGR2_PL_0                          ((uint16_t)0x1000) /* Bit 0 */
#define DMA_CFGR2_PL_1                          ((uint16_t)0x2000) /* Bit 1 */

#define DMA_CFGR2_MEM2MEM                       ((uint16_t)0x4000) /* Memory to memory mode */

/*******************  Bit definition for DMA_CFGR3 register  *******************/
#define DMA_CFGR3_EN                            ((uint16_t)0x0001) /* Channel enable */
#define DMA_CFGR3_TCIE                          ((uint16_t)0x0002) /* Transfer complete interrupt enable */
#define DMA_CFGR3_HTIE                          ((uint16_t)0x0004) /* Half Transfer interrupt enable */
#define DMA_CFGR3_TEIE                          ((uint16_t)0x0008) /* Transfer error interrupt enable */
#define DMA_CFGR3_DIR                           ((uint16_t)0x0010) /* Data transfer direction */
#define DMA_CFGR3_CIRC                          ((uint16_t)0x0020) /* Circular mode */
#define DMA_CFGR3_PINC                          ((uint16_t)0x0040) /* Peripheral increment mode */
#define DMA_CFGR3_MINC                          ((uint16_t)0x0080) /* Memory increment mode */

#define DMA_CFGR3_PSIZE                         ((uint16_t)0x0300) /* PSIZE[1:0] bits (Peripheral size) */
#define DMA_CFGR3_PSIZE_0                       ((uint16_t)0x0100) /* Bit 0 */
#define DMA_CFGR3_PSIZE_1                       ((uint16_t)0x0200) /* Bit 1 */

#define DMA_CFGR3_MSIZE                         ((uint16_t)0x0C00) /* MSIZE[1:0] bits (Memory size) */
#define DMA_CFGR3_MSIZE_0                       ((uint16_t)0x0400) /* Bit 0 */
#define DMA_CFGR3_MSIZE_1                       ((uint16_t)0x0800) /* Bit 1 */

#define DMA_CFGR3_PL                            ((uint16_t)0x3000) /* PL[1:0] bits (Channel Priority level) */
#define DMA_CFGR3_PL_0                          ((uint16_t)0x1000) /* Bit 0 */
#define DMA_CFGR3_PL_1                          ((uint16_t)0x2000) /* Bit 1 */

#define DMA_CFGR3_MEM2MEM                       ((uint16_t)0x4000) /* Memory to memory mode */

/*******************  Bit definition for DMA_CFG4 register  *******************/
#define DMA_CFG4_EN                             ((uint16_t)0x0001) /* Channel enable */
#define DMA_CFG4_TCIE                           ((uint16_t)0x0002) /* Transfer complete interrupt enable */
#define DMA_CFG4_HTIE                           ((uint16_t)0x0004) /* Half Transfer interrupt enable */
#define DMA_CFG4_TEIE                           ((uint16_t)0x0008) /* Transfer error interrupt enable */
#define DMA_CFG4_DIR                            ((uint16_t)0x0010) /* Data transfer direction */
#define DMA_CFG4_CIRC                           ((uint16_t)0x0020) /* Circular mode */
#define DMA_CFG4_PINC                           ((uint16_t)0x0040) /* Peripheral increment mode */
#define DMA_CFG4_MINC                           ((uint16_t)0x0080) /* Memory increment mode */

#define DMA_CFG4_PSIZE                          ((uint16_t)0x0300) /* PSIZE[1:0] bits (Peripheral size) */
#define DMA_CFG4_PSIZE_0                        ((uint16_t)0x0100) /* Bit 0 */
#define DMA_CFG4_PSIZE_1                        ((uint16_t)0x0200) /* Bit 1 */

#define DMA_CFG4_MSIZE                          ((uint16_t)0x0C00) /* MSIZE[1:0] bits (Memory size) */
#define DMA_CFG4_MSIZE_0                        ((uint16_t)0x0400) /* Bit 0 */
#define DMA_CFG4_MSIZE_1                        ((uint16_t)0x0800) /* Bit 1 */

#define DMA_CFG4_PL                             ((uint16_t)0x3000) /* PL[1:0] bits (Channel Priority level) */
#define DMA_CFG4_PL_0                           ((uint16_t)0x1000) /* Bit 0 */
#define DMA_CFG4_PL_1                           ((uint16_t)0x2000) /* Bit 1 */

#define DMA_CFG4_MEM2MEM                        ((uint16_t)0x4000) /* Memory to memory mode */

/******************  Bit definition for DMA_CFG5 register  *******************/
#define DMA_CFG5_EN                             ((uint16_t)0x0001) /* Channel enable */
#define DMA_CFG5_TCIE                           ((uint16_t)0x0002) /* Transfer complete interrupt enable */
#define DMA_CFG5_HTIE                           ((uint16_t)0x0004) /* Half Transfer interrupt enable */
#define DMA_CFG5_TEIE                           ((uint16_t)0x0008) /* Transfer error interrupt enable */
#define DMA_CFG5_DIR                            ((uint16_t)0x0010) /* Data transfer direction */
#define DMA_CFG5_CIRC                           ((uint16_t)0x0020) /* Circular mode */
#define DMA_CFG5_PINC                           ((uint16_t)0x0040) /* Peripheral increment mode */
#define DMA_CFG5_MINC                           ((uint16_t)0x0080) /* Memory increment mode */

#define DMA_CFG5_PSIZE                          ((uint16_t)0x0300) /* PSIZE[1:0] bits (Peripheral size) */
#define DMA_CFG5_PSIZE_0                        ((uint16_t)0x0100) /* Bit 0 */
#define DMA_CFG5_PSIZE_1                        ((uint16_t)0x0200) /* Bit 1 */

#define DMA_CFG5_MSIZE                          ((uint16_t)0x0C00) /* MSIZE[1:0] bits (Memory size) */
#define DMA_CFG5_MSIZE_0                        ((uint16_t)0x0400) /* Bit 0 */
#define DMA_CFG5_MSIZE_1                        ((uint16_t)0x0800) /* Bit 1 */

#define DMA_CFG5_PL                             ((uint16_t)0x3000) /* PL[1:0] bits (Channel Priority level) */
#define DMA_CFG5_PL_0                           ((uint16_t)0x1000) /* Bit 0 */
#define DMA_CFG5_PL_1                           ((uint16_t)0x2000) /* Bit 1 */

#define DMA_CFG5_MEM2MEM                        ((uint16_t)0x4000) /* Memory to memory mode enable */

/*******************  Bit definition for DMA_CFG6 register  *******************/
#define DMA_CFG6_EN                             ((uint16_t)0x0001) /* Channel enable */
#define DMA_CFG6_TCIE                           ((uint16_t)0x0002) /* Transfer complete interrupt enable */
#define DMA_CFG6_HTIE                           ((uint16_t)0x0004) /* Half Transfer interrupt enable */
#define DMA_CFG6_TEIE                           ((uint16_t)0x0008) /* Transfer error interrupt enable */
#define DMA_CFG6_DIR                            ((uint16_t)0x0010) /* Data transfer direction */
#define DMA_CFG6_CIRC                           ((uint16_t)0x0020) /* Circular mode */
#define DMA_CFG6_PINC                           ((uint16_t)0x0040) /* Peripheral increment mode */
#define DMA_CFG6_MINC                           ((uint16_t)0x0080) /* Memory increment mode */

#define DMA_CFG6_PSIZE                          ((uint16_t)0x0300) /* PSIZE[1:0] bits (Peripheral size) */
#define DMA_CFG6_PSIZE_0                        ((uint16_t)0x0100) /* Bit 0 */
#define DMA_CFG6_PSIZE_1                        ((uint16_t)0x0200) /* Bit 1 */

#define DMA_CFG6_MSIZE                          ((uint16_t)0x0C00) /* MSIZE[1:0] bits (Memory size) */
#define DMA_CFG6_MSIZE_0                        ((uint16_t)0x0400) /* Bit 0 */
#define DMA_CFG6_MSIZE_1                        ((uint16_t)0x0800) /* Bit 1 */

#define DMA_CFG6_PL                             ((uint16_t)0x3000) /* PL[1:0] bits (Channel Priority level) */
#define DMA_CFG6_PL_0                           ((uint16_t)0x1000) /* Bit 0 */
#define DMA_CFG6_PL_1                           ((uint16_t)0x2000) /* Bit 1 */

#define DMA_CFG6_MEM2MEM                        ((uint16_t)0x4000) /* Memory to memory mode */

/*******************  Bit definition for DMA_CFG7 register  *******************/
#define DMA_CFG7_EN                             ((uint16_t)0x0001) /* Channel enable */
#define DMA_CFG7_TCIE                           ((uint16_t)0x0002) /* Transfer complete interrupt enable */
#define DMA_CFG7_HTIE                           ((uint16_t)0x0004) /* Half Transfer interrupt enable */
#define DMA_CFG7_TEIE                           ((uint16_t)0x0008) /* Transfer error interrupt enable */
#define DMA_CFG7_DIR                            ((uint16_t)0x0010) /* Data transfer direction */
#define DMA_CFG7_CIRC                           ((uint16_t)0x0020) /* Circular mode */
#define DMA_CFG7_PINC                           ((uint16_t)0x0040) /* Peripheral increment mode */
#define DMA_CFG7_MINC                           ((uint16_t)0x0080) /* Memory increment mode */

#define DMA_CFG7_PSIZE                          ((uint16_t)0x0300) /* PSIZE[1:0] bits (Peripheral size) */
#define DMA_CFG7_PSIZE_0                        ((uint16_t)0x0100) /* Bit 0 */
#define DMA_CFG7_PSIZE_1                        ((uint16_t)0x0200) /* Bit 1 */

#define DMA_CFG7_MSIZE                          ((uint16_t)0x0C00) /* MSIZE[1:0] bits (Memory size) */
#define DMA_CFG7_MSIZE_0                        ((uint16_t)0x0400) /* Bit 0 */
#define DMA_CFG7_MSIZE_1                        ((uint16_t)0x0800) /* Bit 1 */

#define DMA_CFG7_PL                             ((uint16_t)0x3000) /* PL[1:0] bits (Channel Priority level) */
#define DMA_CFG7_PL_0                           ((uint16_t)0x1000) /* Bit 0 */
#define DMA_CFG7_PL_1                           ((uint16_t)0x2000) /* Bit 1 */

#define DMA_CFG7_MEM2MEM                        ((uint16_t)0x4000) /* Memory to memory mode enable */

/******************  Bit definition for DMA_CNTR1 register  ******************/
#define DMA_CNTR1_NDT                           ((uint16_t)0xFFFF) /* Number of data to Transfer */

/******************  Bit definition for DMA_CNTR2 register  ******************/
#define DMA_CNTR2_NDT                           ((uint16_t)0xFFFF) /* Number of data to Transfer */

/******************  Bit definition for DMA_CNTR3 register  ******************/
#define DMA_CNTR3_NDT                           ((uint16_t)0xFFFF) /* Number of data to Transfer */

/******************  Bit definition for DMA_CNTR4 register  ******************/
#define DMA_CNTR4_NDT                           ((uint16_t)0xFFFF) /* Number of data to Transfer */

/******************  Bit definition for DMA_CNTR5 register  ******************/
#define DMA_CNTR5_NDT                           ((uint16_t)0xFFFF) /* Number of data to Transfer */

/******************  Bit definition for DMA_CNTR6 register  ******************/
#define DMA_CNTR6_NDT                           ((uint16_t)0xFFFF) /* Number of data to Transfer */

/******************  Bit definition for DMA_CNTR7 register  ******************/
#define DMA_CNTR7_NDT                           ((uint16_t)0xFFFF) /* Number of data to Transfer */

/******************  Bit definition for DMA_PADDR1 register  *******************/
#define DMA_PADDR1_PA                           ((uint32_t)0xFFFFFFFF) /* Peripheral Address */

/******************  Bit definition for DMA_PADDR2 register  *******************/
#define DMA_PADDR2_PA                           ((uint32_t)0xFFFFFFFF) /* Peripheral Address */

/******************  Bit definition for DMA_PADDR3 register  *******************/
#define DMA_PADDR3_PA                           ((uint32_t)0xFFFFFFFF) /* Peripheral Address */

/******************  Bit definition for DMA_PADDR4 register  *******************/
#define DMA_PADDR4_PA                           ((uint32_t)0xFFFFFFFF) /* Peripheral Address */

/******************  Bit definition for DMA_PADDR5 register  *******************/
#define DMA_PADDR5_PA                           ((uint32_t)0xFFFFFFFF) /* Peripheral Address */

/******************  Bit definition for DMA_PADDR6 register  *******************/
#define DMA_PADDR6_PA                           ((uint32_t)0xFFFFFFFF) /* Peripheral Address */

/******************  Bit definition for DMA_PADDR7 register  *******************/
#define DMA_PADDR7_PA                           ((uint32_t)0xFFFFFFFF) /* Peripheral Address */

/******************  Bit definition for DMA_MADDR1 register  *******************/
#define DMA_MADDR1_MA                           ((uint32_t)0xFFFFFFFF) /* Memory Address */

/******************  Bit definition for DMA_MADDR2 register  *******************/
#define DMA_MADDR2_MA                           ((uint32_t)0xFFFFFFFF) /* Memory Address */

/******************  Bit definition for DMA_MADDR3 register  *******************/
#define DMA_MADDR3_MA                           ((uint32_t)0xFFFFFFFF) /* Memory Address */

/******************  Bit definition for DMA_MADDR4 register  *******************/
#define DMA_MADDR4_MA                           ((uint32_t)0xFFFFFFFF) /* Memory Address */

/******************  Bit definition for DMA_MADDR5 register  *******************/
#define DMA_MADDR5_MA                           ((uint32_t)0xFFFFFFFF) /* Memory Address */

/******************  Bit definition for DMA_MADDR6 register  *******************/
#define DMA_MADDR6_MA                           ((uint32_t)0xFFFFFFFF) /* Memory Address */

/******************  Bit definition for DMA_MADDR7 register  *******************/
#define DMA_MADDR7_MA                           ((uint32_t)0xFFFFFFFF) /* Memory Address */

/******************************************************************************/
/*                    External Interrupt/Event Controller                     */
/******************************************************************************/

/*******************  Bit definition for EXTI_INTENR register  *******************/
#define EXTI_INTENR_MR0                         ((uint32_t)0x00000001) /* Interrupt Mask on line 0 */
#define EXTI_INTENR_MR1                         ((uint32_t)0x00000002) /* Interrupt Mask on line 1 */
#define EXTI_INTENR_MR2                         ((uint32_t)0x00000004) /* Interrupt Mask on line 2 */
#define EXTI_INTENR_MR3                         ((uint32_t)0x00000008) /* Interrupt Mask on line 3 */
#define EXTI_INTENR_MR4                         ((uint32_t)0x00000010) /* Interrupt Mask on line 4 */
#define EXTI_INTENR_MR5                         ((uint32_t)0x00000020) /* Interrupt Mask on line 5 */
#define EXTI_INTENR_MR6                         ((uint32_t)0x00000040) /* Interrupt Mask on line 6 */
#define EXTI_INTENR_MR7                         ((uint32_t)0x00000080) /* Interrupt Mask on line 7 */
#define EXTI_INTENR_MR8                         ((uint32_t)0x00000100) /* Interrupt Mask on line 8 */
#define EXTI_INTENR_MR9                         ((uint32_t)0x00000200) /* Interrupt Mask on line 9 */

/*******************  Bit definition for EXTI_EVENR register  *******************/
#define EXTI_EVENR_MR0                          ((uint32_t)0x00000001) /* Event Mask on line 0 */
#define EXTI_EVENR_MR1                          ((uint32_t)0x00000002) /* Event Mask on line 1 */
#define EXTI_EVENR_MR2                          ((uint32_t)0x00000004) /* Event Mask on line 2 */
#define EXTI_EVENR_MR3                          ((uint32_t)0x00000008) /* Event Mask on line 3 */
#define EXTI_EVENR_MR4                          ((uint32_t)0x00000010) /* Event Mask on line 4 */
#define EXTI_EVENR_MR5                          ((uint32_t)0x00000020) /* Event Mask on line 5 */
#define EXTI_EVENR_MR6                          ((uint32_t)0x00000040) /* Event Mask on line 6 */
#define EXTI_EVENR_MR7                          ((uint32_t)0x00000080) /* Event Mask on line 7 */
#define EXTI_EVENR_MR8                          ((uint32_t)0x00000100) /* Event Mask on line 8 */
#define EXTI_EVENR_MR9                          ((uint32_t)0x00000200) /* Event Mask on line 9 */

/******************  Bit definition for EXTI_RTENR register  *******************/
#define EXTI_RTENR_TR0                          ((uint32_t)0x00000001) /* Rising trigger event configuration bit of line 0 */
#define EXTI_RTENR_TR1                          ((uint32_t)0x00000002) /* Rising trigger event configuration bit of line 1 */
#define EXTI_RTENR_TR2                          ((uint32_t)0x00000004) /* Rising trigger event configuration bit of line 2 */
#define EXTI_RTENR_TR3                          ((uint32_t)0x00000008) /* Rising trigger event configuration bit of line 3 */
#define EXTI_RTENR_TR4                          ((uint32_t)0x00000010) /* Rising trigger event configuration bit of line 4 */
#define EXTI_RTENR_TR5                          ((uint32_t)0x00000020) /* Rising trigger event configuration bit of line 5 */
#define EXTI_RTENR_TR6                          ((uint32_t)0x00000040) /* Rising trigger event configuration bit of line 6 */
#define EXTI_RTENR_TR7                          ((uint32_t)0x00000080) /* Rising trigger event configuration bit of line 7 */
#define EXTI_RTENR_TR8                          ((uint32_t)0x00000100) /* Rising trigger event configuration bit of line 8 */
#define EXTI_RTENR_TR9                          ((uint32_t)0x00000200) /* Rising trigger event configuration bit of line 9 */
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
