wagiminator/CH32V003-GameConsole/(commit log)

2024-07-31 New buzzer circuit
    [GameConsole_v1.0_BOM.tsv, GameConsole_v1.1_BOM.tsv]
2026-10-28 Added 3d printable case
2026-10-31 Update 3D-printable case
