wagiminator/CH32V003-GameConsole/(notices)

Notices in the files:
software/tiny_invaders/src/main.c:
Tiny Invaders v3.1 is free software: you can redistribute it and/or modify
it under the terms of the GNU General Public License as published by
the Free Software Foundation, either version 3 of the License, or
(at your option) any later version.
software/tiny_lander/src/main.c:
>>>>> T-I-N-Y L-A-N-D-E-R v1.0 for ATTINY85 GPLv3 <<<<
Tiny Lander v1.0 is free software: you can redistribute it and/or modify
